GabiAndi/UNER_Autito_PCB/Presentacion/Informe.pdf

# Facultad de Ciencias de la Alimentación

Universidad Nacional de Entre Ríos

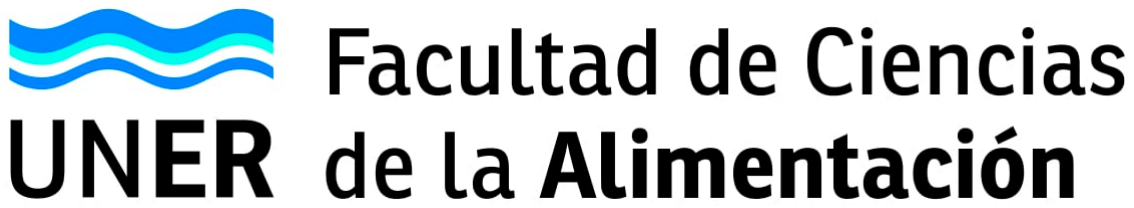
[picture p3: figure]

AUTITO MICROCONTROLADORES
Crédito de diseño y manufactura de PCB

GABRIEL ANDRÉS AGUIRRE
19 de abril de 2021

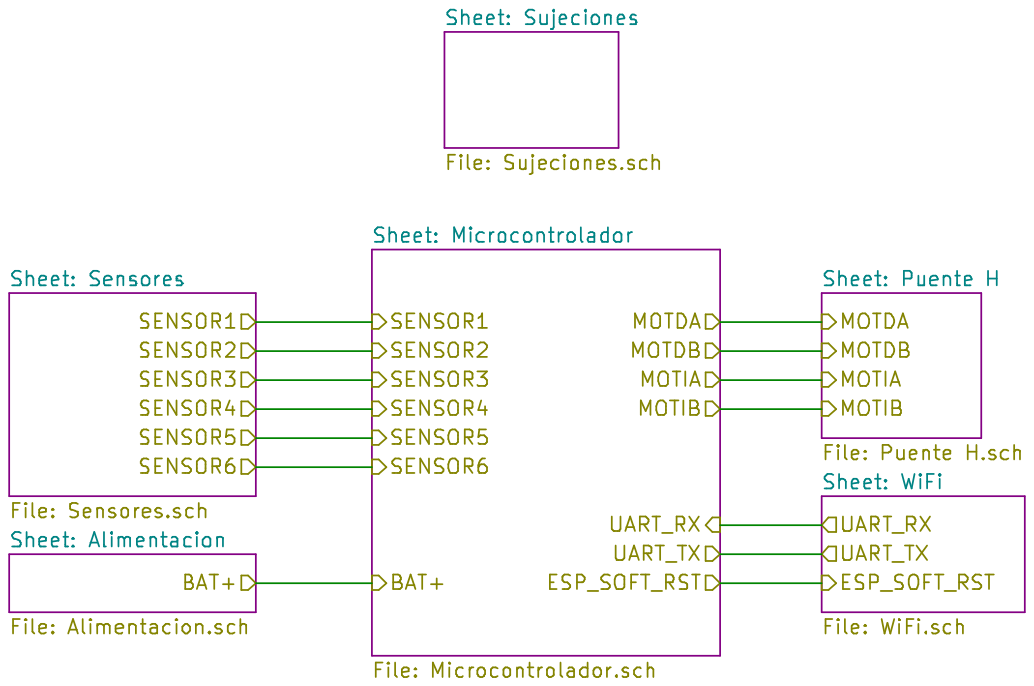
[picture p4: page 2]

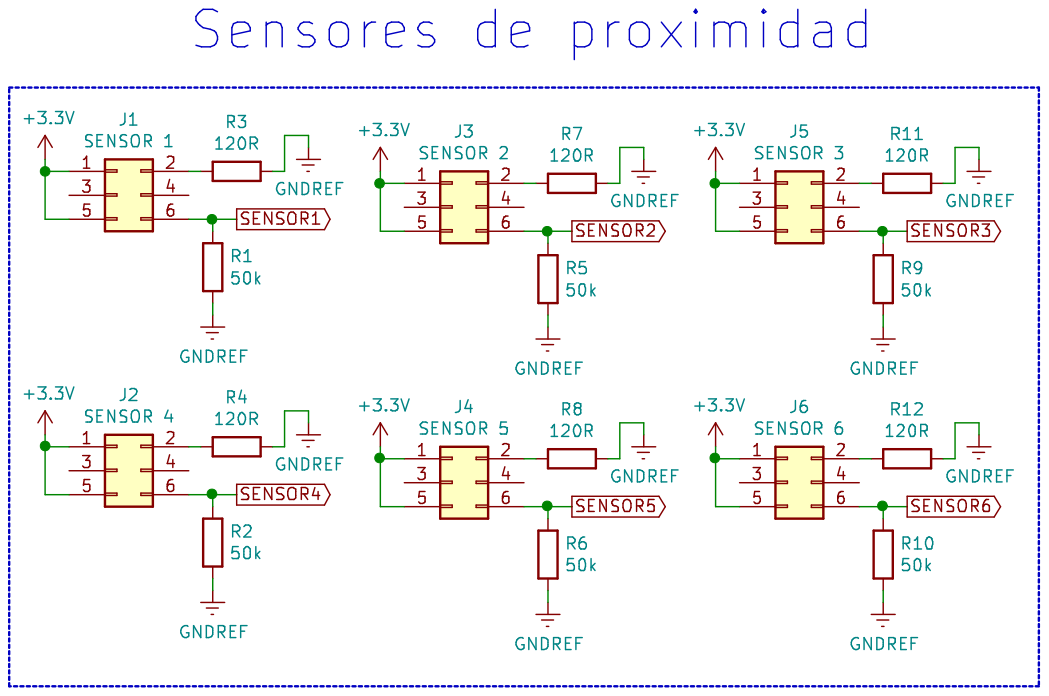
[picture p5: page 3]

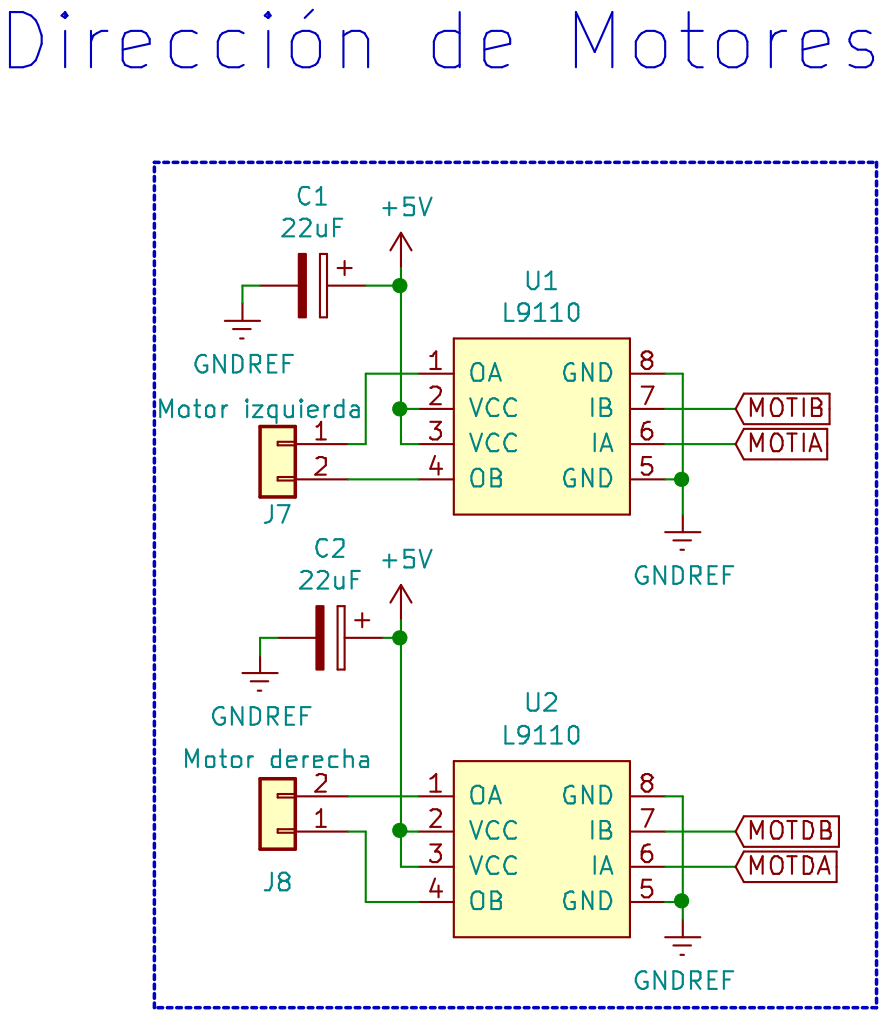
[picture p6: page 4]

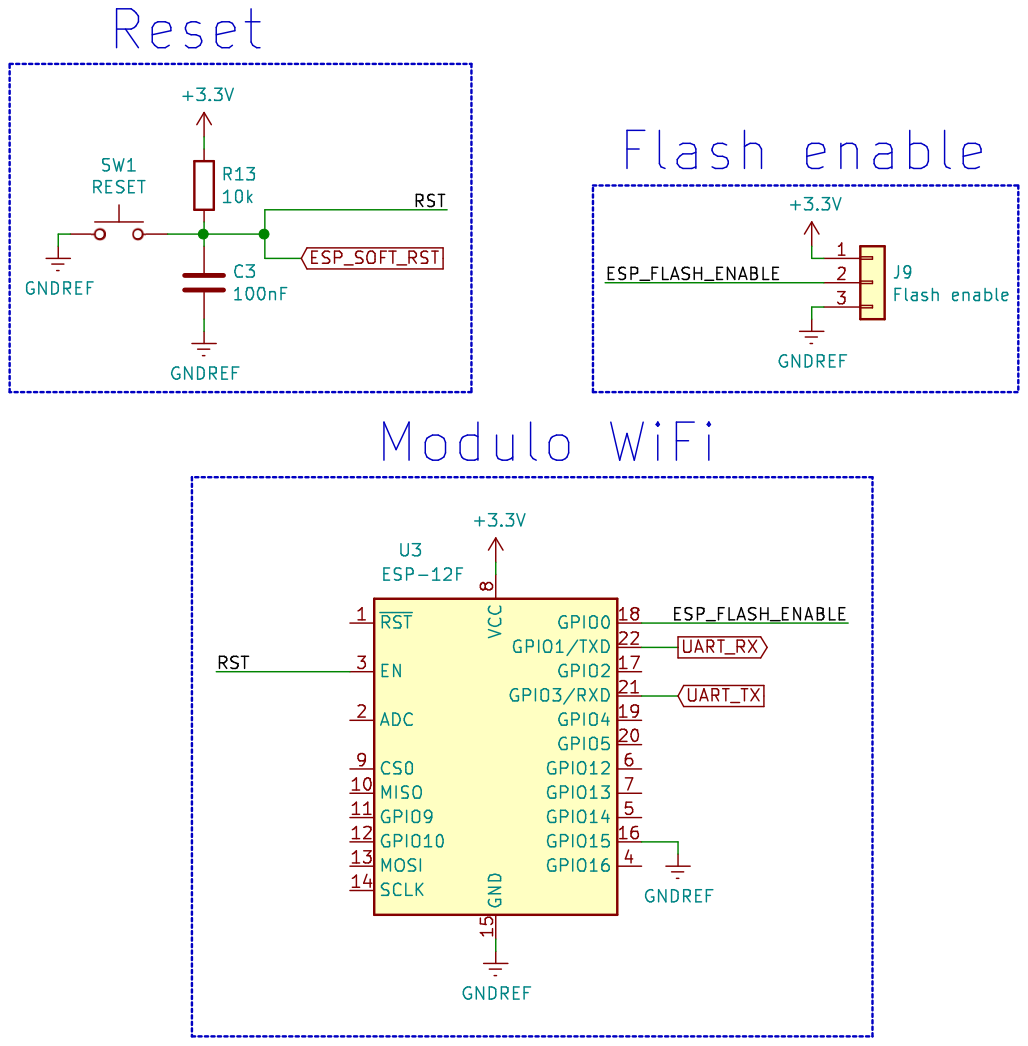
[picture p7: page 5]

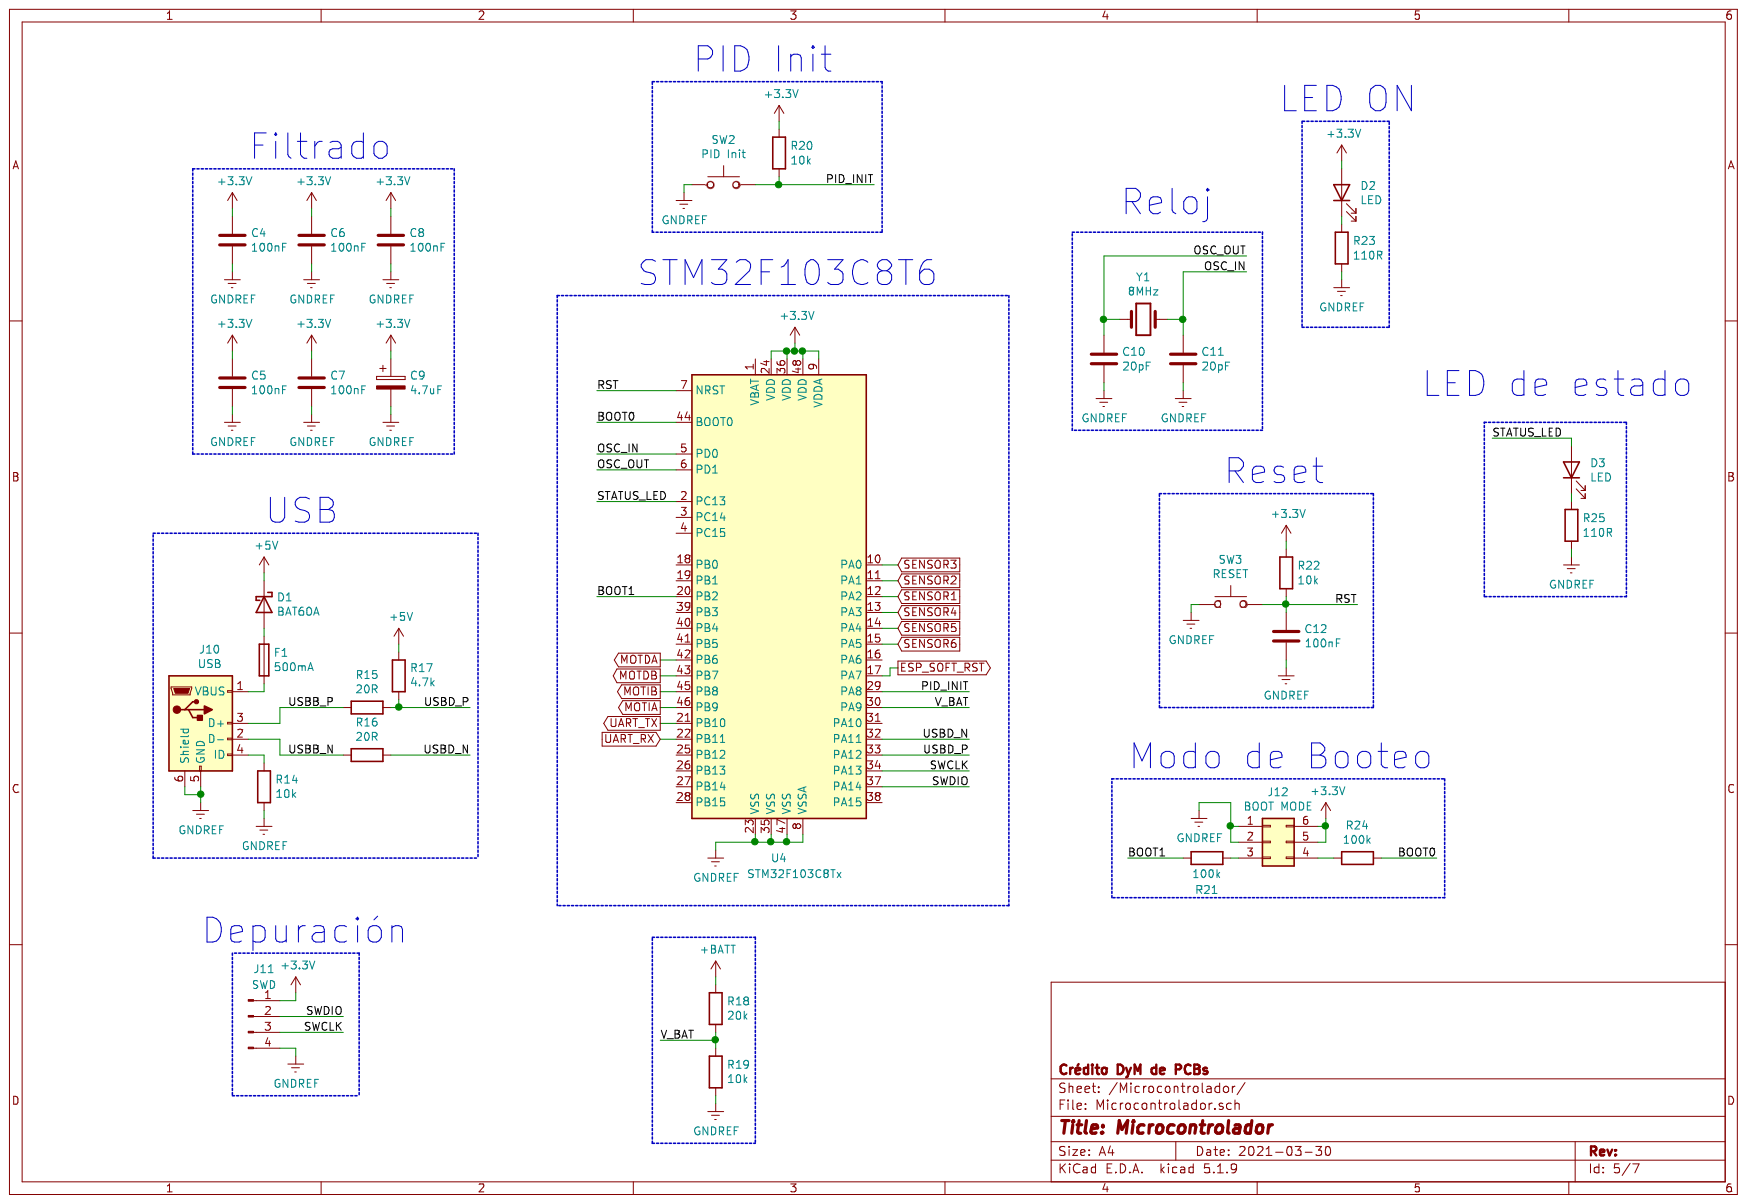
[picture p8: page 6]

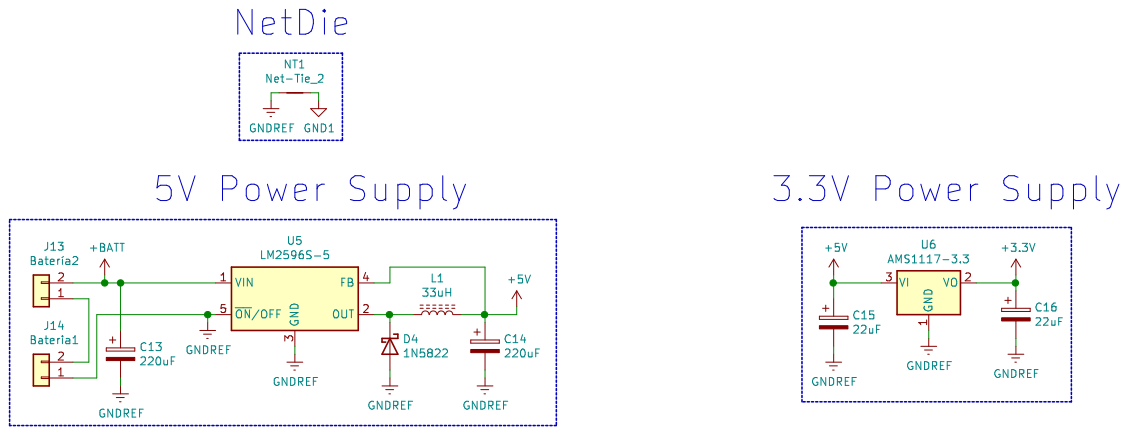
[picture p9: page 7]

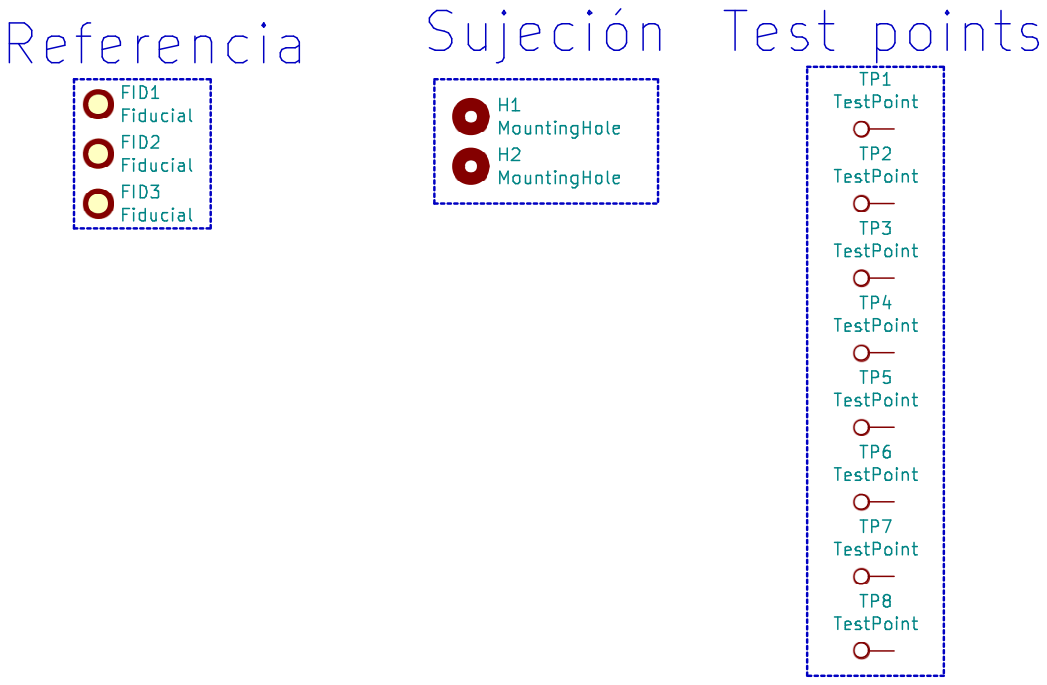
[picture p10: page 8]

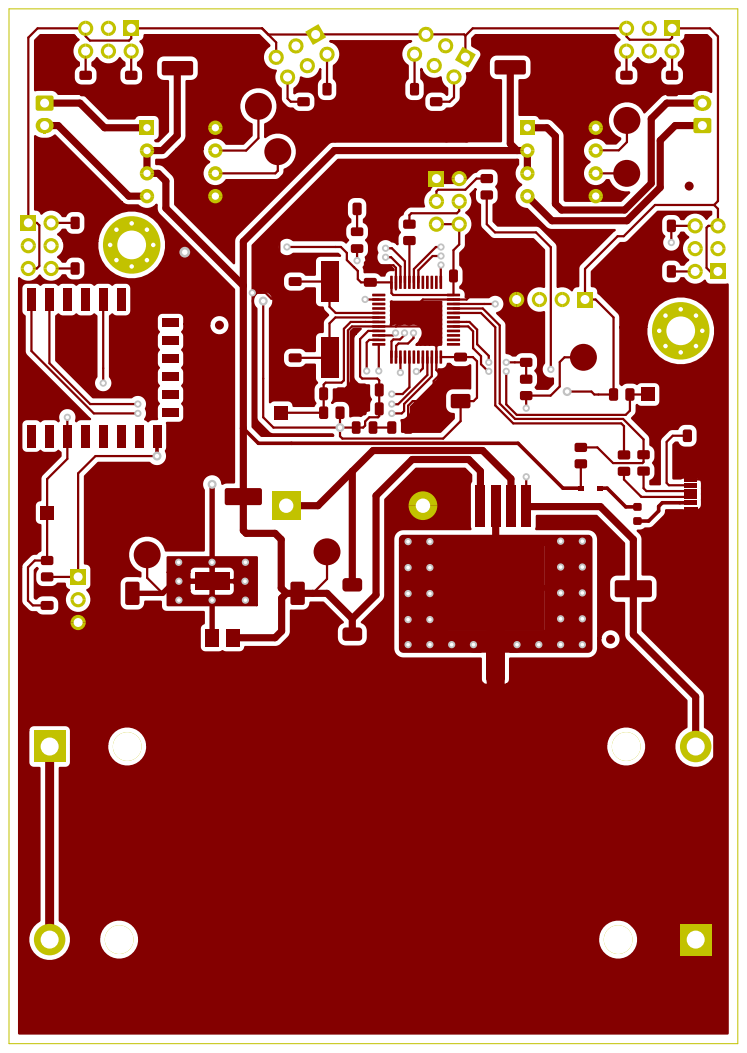
[picture p11: page 9]

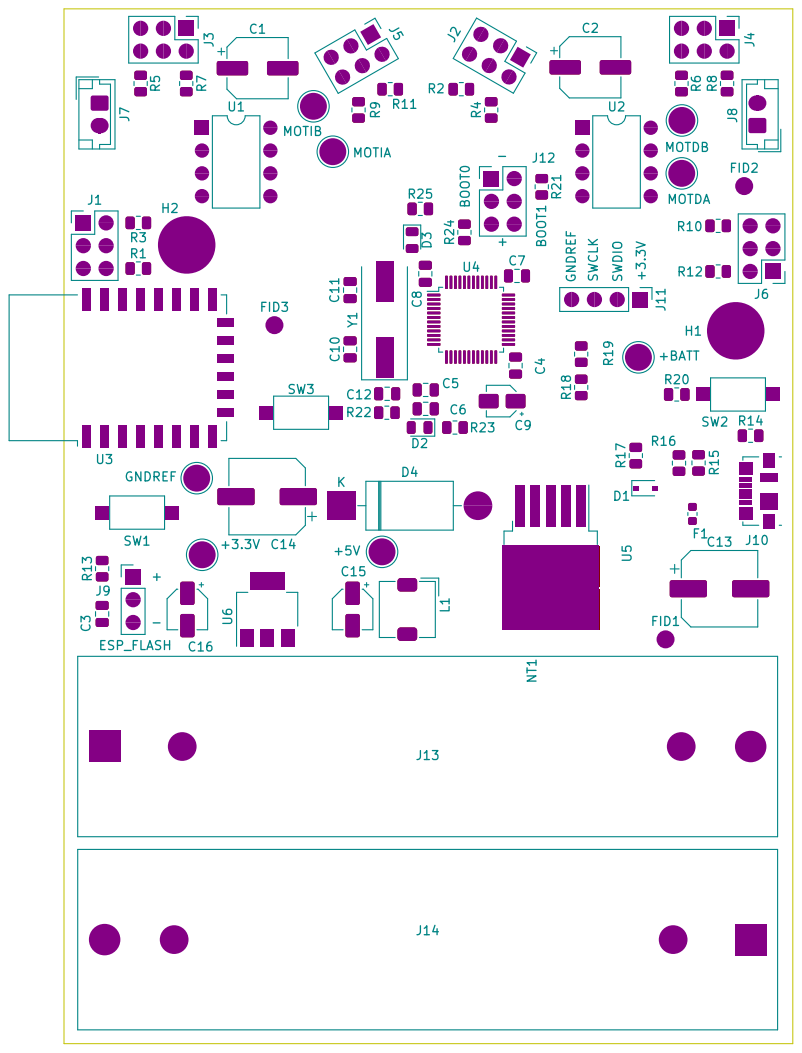
[picture p12: page 10]

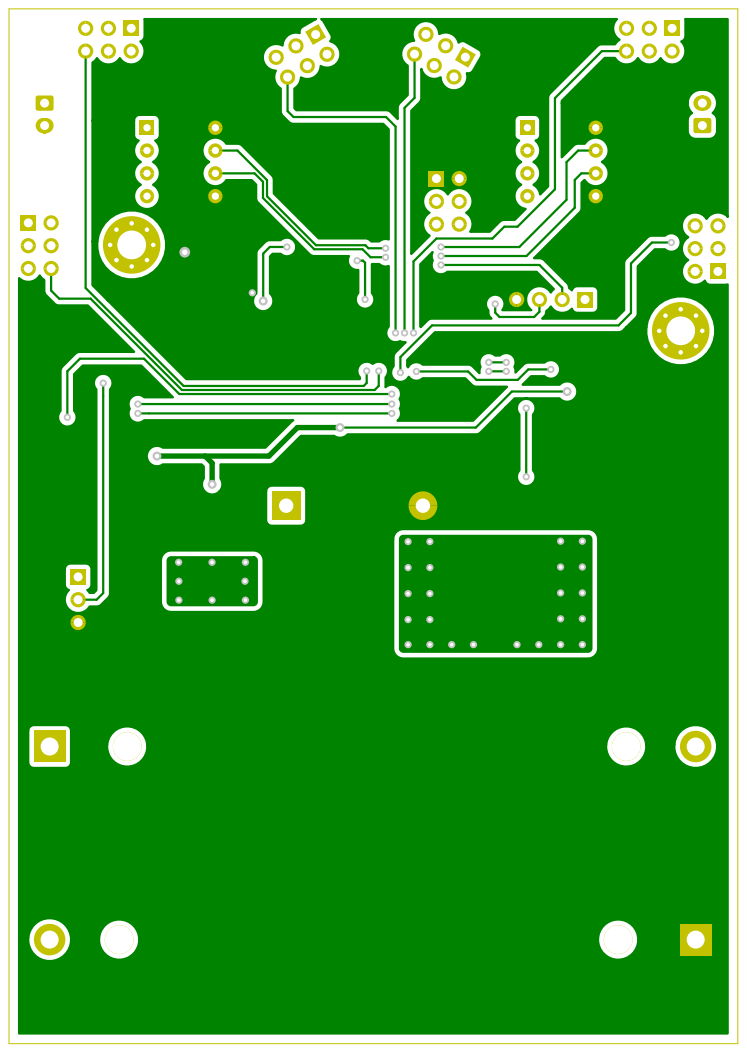
[picture p13: page 11]

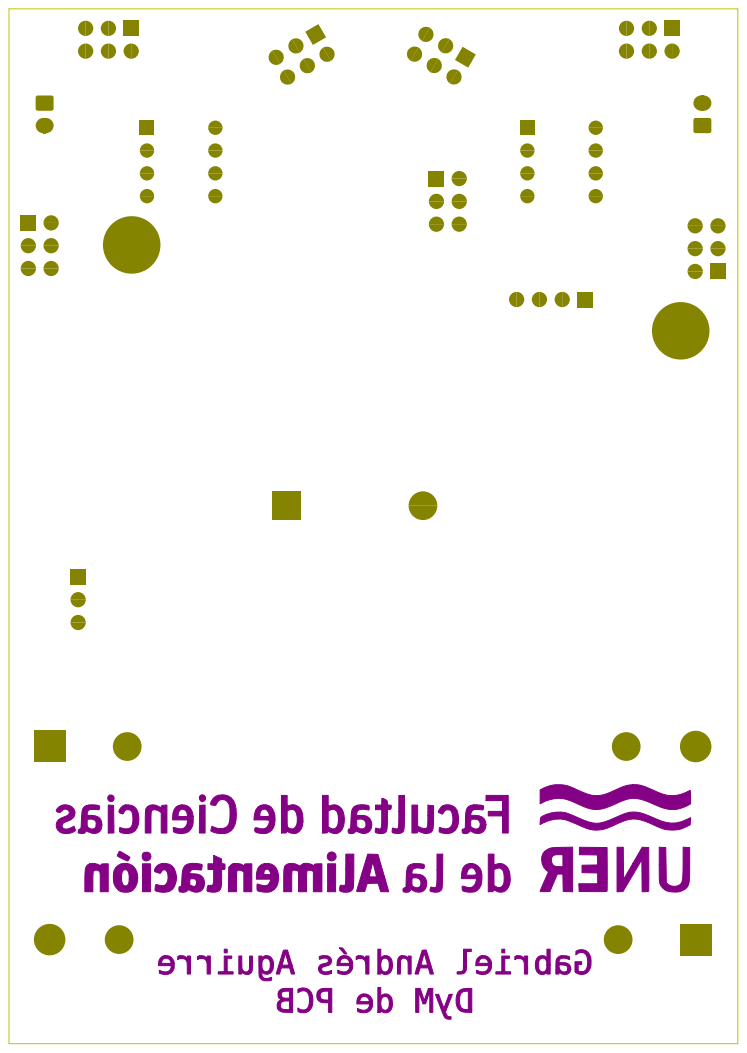
[picture p14: page 12]

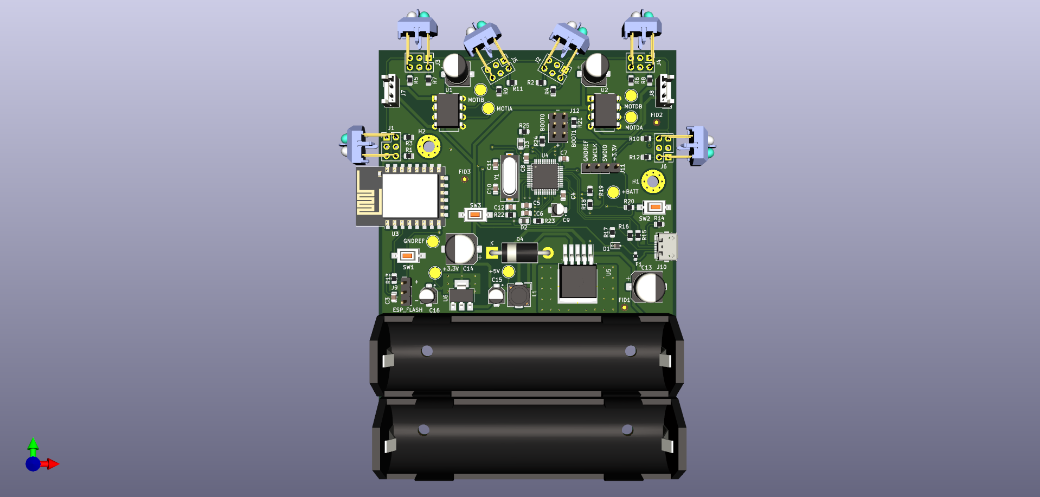
[picture p15: page 13]
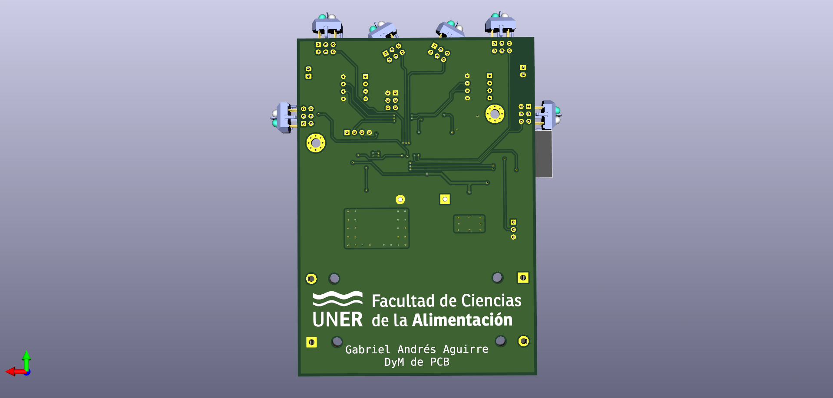
[picture p16: page 14]
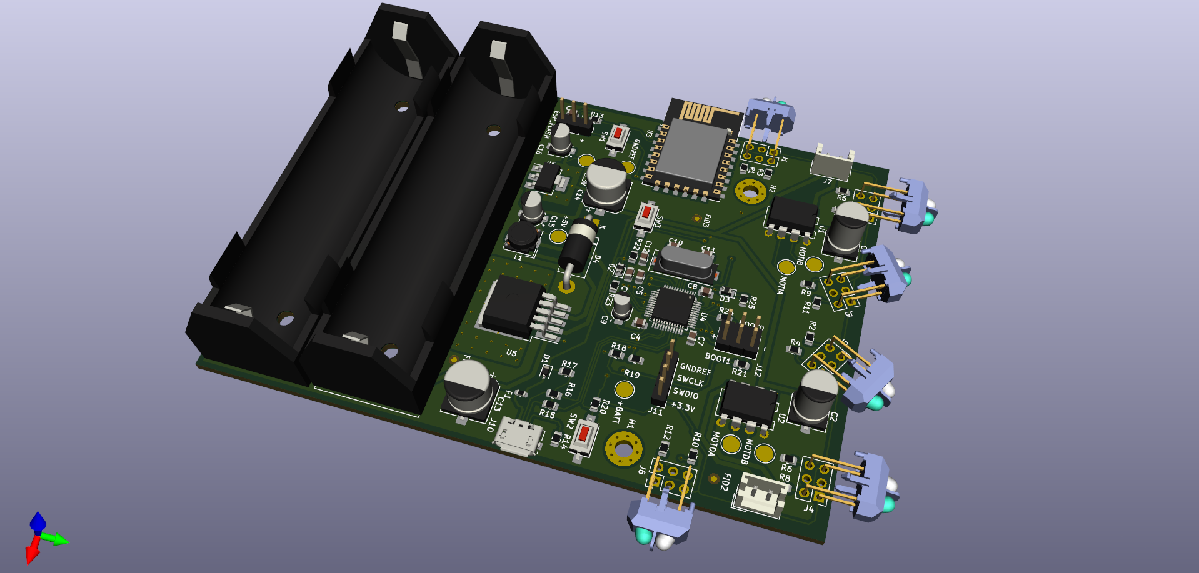
[picture p17: page 15]
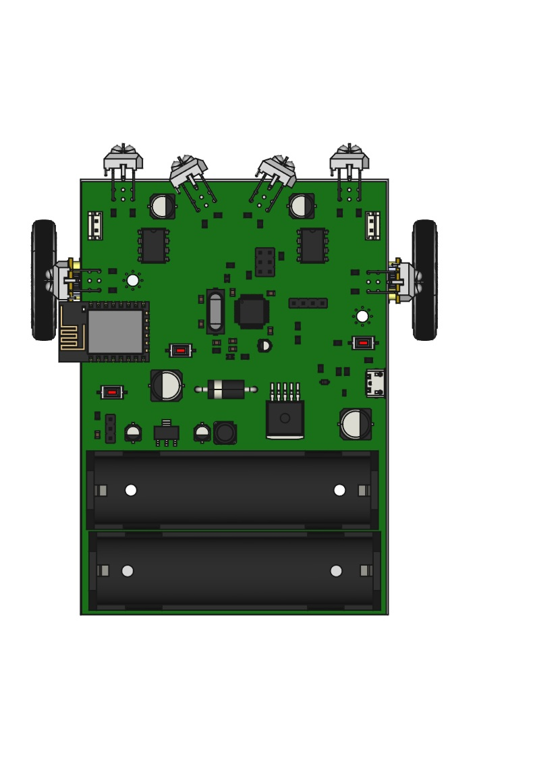
[picture p18: page 16]
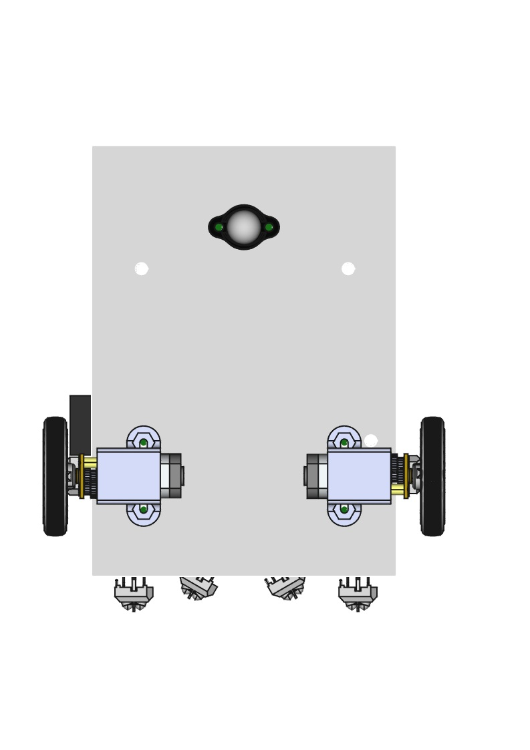
[picture p19: page 17]
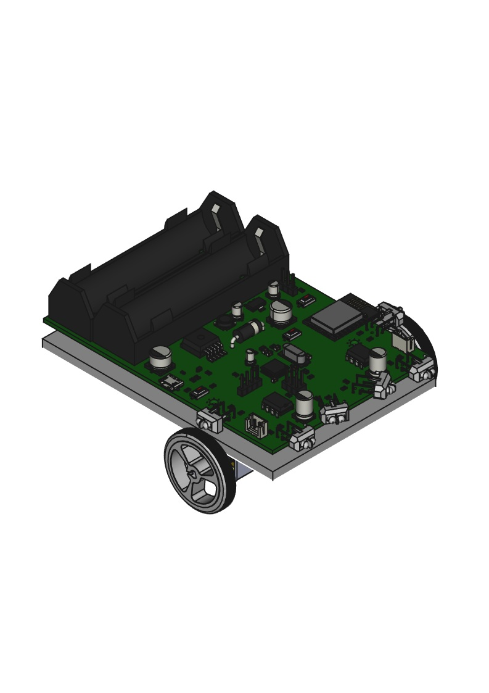
[picture p20: page 18]

# Autito Microcontroladores

## Gabriel Andrés Aguirre

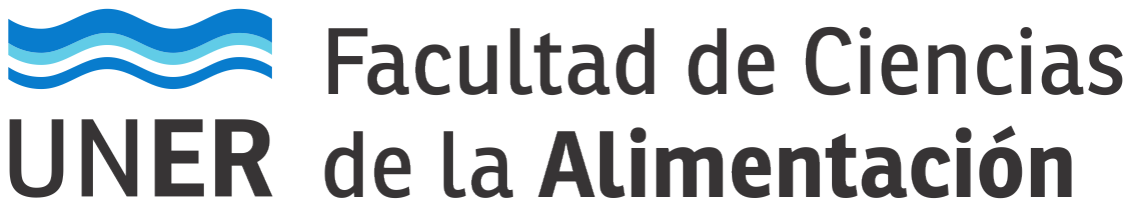
[picture p21: figure]

Componente | Referencia | Valor | Footprint | Link | Precio unidad Precio unidad Cantidad Precio | Fabricante | N.º Fabricante | Mouser N.º
Resistencias de 50k | R10, R6, R2, R9, R5, R1 | 50k | Resistor_SMD:R_0805_2012Metric | 71,32 ARS | $0,51 | 6 | $3,06 KOA Speer | RN73H2ATTD1503B25 (https://ar.mouser.com/ProductDetail/KOA-Speer/RN73H2ATTD1503B25?qs=pJKkPLTLvBhutKSsoiT5Zg%3D%3D) | 660-RN73H2ATD1503B25
Sensores infrarojos | J6, J5, J2, J4, J1, J3 | SENSOR | Mis_componentes:TCRT5000 | 121,54 ARS | $0,87 | 6 | $5,21 Vishay Semiconductors TCRT5000 (https://ar.mouser.com/ProductDetail/Vishay-Semiconductors/TCRT5000?qs=glpcD2KT6uaaYldHGIIt5g%3D%3D) | 782-TCRT5000
Resistencia de 120R | R12, R8, R4, R11, R7, R3 | 120R | Resistor_SMD:R_0805_2012Metric | 70,32 ARS | $0,50 | 6 | $3,01 Panasonic | ERA-6VEB1200V (https://ar.mouser.com/ProductDetail/Panasonic/ERA-6VEB1200V?qs=rI7uf1IzohQDwVDMjI%252BQDA%3D%3D) | 667-ERA-6VEB1200V
Puente H | U1, U2 | L9110 | Package_DIP:DIP-8_W7.62mm | 150,68 ARS | $1,08 | 2 | $2,15 Adafruit | 4489 (https://ar.mouser.com/ProductDetail/Adafruit/4489) | 485-4489
Capacitor de 22uF | C1, C2, C16, C15 | 22uF | Capacitor_SMD:CP_Elec_6.3x9.9 | 32,14 ARS | $0,23 | 4 | $0,92 Panasonic | EEE-FN1C220R (https://ar.mouser.com/ProductDetail/Panasonic/EEE-FN1C220R?qs=OlC7AqGiEDl1qZfBJQUkaQ%3D%3D) | 667-EEE-FN1C220R
Conector para motores | J7, J8 | Motor | Connector_JST:JST_EH_B2B-EH-A_1x02_P2.50mm_Vertical | 80,36 ARS | $0,57 | 2 | $1,15 JST Automotive | S06B-AIT2-1AK (https://ar.mouser.com/ProductDetail/JST-Automotive/S06B-AIT2-1AK?qs=XoGB3caz5%2FavEEj5oQr9Kw%3D%3D) | 306-S06B-AIT2-1AK
Modulo WiFi ESP8266 | U3 | ESP-12F | RF_Module:ESP-12E | 698,13 ARS | $4,99 | 1 | $4,99 Adafruit | 2491 (https://ar.mouser.com/ProductDetail/Adafruit/2491?qs=N%2F3wi2MvZWDVFv7HwruvGQ%3D%3D) | 485-2491
Capacitor de 100nF | C3, C4, C6, C5, C8, C12, C7 | 100nF | Capacitor_SMD:C_0805_2012Metric | 52,23 ARS | $0,37 | 7 | $2,61 KEMET | C0805X104M5RACTU (https://ar.mouser.com/ProductDetail/KEMET/C0805X104M5RACTU?qs=1xOl%2F8aMGNq7VJopyoJi7Q%3D%3D) | 80-C0805X104M5RACTU
Capacitor de 20pF | C10, C11 | 20pF | Capacitor_SMD:C_0805_2012Metric | 49,22 ARS | $0,35 | 2 | $0,70 AVX | 08055A200F4T2A (https://ar.mouser.com/ProductDetail/AVX/08055A200F4T2A?qs=XLNwXgtzMM869%252Bh%252B5tS56A%3D%3D) | 581-08055A200F4T2A
Boton pulsador pequeño | SW1, SW2, SW3 | Button | Button_Switch_SMD:SW_SPST_CK_RS282G05A3 | 10,05 ARS | $0,07 | 3 | $0,22 C&K (https://ar.mouser.com/ProductDetail/?qs=vLWxofP3U2xHB0Q2opWSaw%3D%3D) | PTS636 SL43 LFS | 611-PTS636SL43LFS
Resistencia de 10k | R13, R22, R14, R19, R20 | 10k | Resistor_SMD:R_0805_2012Metric | 10,05 ARS | $0,07 | 5 | $0,36 Vishay / Dale | CRCW080510K0FKEAC (https://ar.mouser.com/ProductDetail/Vishay-Dale/CRCW080510K0FKEAC?qs=E3Y5ESvWgWORadmUijPtxQ%3D%3D) | 71-CRCW080510K0FKEAC
PinHeader 01x03 | J9 | Flash enable | Connector_PinHeader_2.54mm:PinHeader_1x03_P2.54mm_Vertical | 149,67 ARS | $1,07 | 1 | $1,07 Digilent | 240-004 (https://ar.mouser.com/ProductDetail/Digilent/240-004?qs=s%2FdyVPQMB4wm5CaIPwvncg%3D%3D) | 424-6-PIN-HEADER
Cristal de 8MHz | Y1 | 8MHz | Crystal:Crystal_SMD_HC49-SD | 156,70 ARS | $1,12 | 1 | $1,12 ECS | ECS-80-20-5PVX-TR (https://ar.mouser.com/ProductDetail/ECS/ECS-80-20-5PVX-TR?qs=5lHMIjPfuwLhObXAxP2jYw%3D%3D) | 520-ECS-80-20-5PVX
Resistencia de 100k | R24, R21 | 100k | Resistor_SMD:R_0805_2012Metric | 10,05 ARS | $0,07 | 2 | $0,14 Vishay / Dale | CRCW0805100KJNEAC (https://ar.mouser.com/ProductDetail/Vishay-Dale/CRCW0805100KJNEAC?qs=E3Y5ESvWgWMMFQOyHSPe4Q%3D%3D) | 71-CRCW0805100KJNEAC
PinHeader 02x03 | J12 | BOOT MODE | Connector_PinHeader_2.54mm:PinHeader_2x03_P2.54mm_Vertical | 210,95 ARS | $1,51 | 1 | $1,51 Digilent | 240-062 (https://ar.mouser.com/ProductDetail/Digilent/240-062?qs=s%2FdyVPQMB4zHQ1ZSIfSl4A%3D%3D) | 424-2X6-PIN-HEADER
PinHeader 01x04 | J11 | SWD | Connector_PinHeader_2.54mm:PinHeader_1x04_P2.54mm_Vertical | 149,67 ARS | $1,07 | 1 | $1,07 Digilent | 240-004 (https://ar.mouser.com/ProductDetail/Digilent/240-004?qs=s%2FdyVPQMB4wm5CaIPwvncg%3D%3D) | 424-6-PIN-HEADER
Resistencia de 20R | R15, R16 | 20R | Resistor_SMD:R_0805_2012Metric | 25,11 ARS | $0,18 | 2 | $0,36 Vishay / Dale | RCS080520R0FKEA (https://ar.mouser.com/ProductDetail/Vishay-Dale/RCS080520R0FKEA?qs=AAB0DUhlpksnVW12to%2FpqA%3D%3D) | 71-RCS080520R0FKEA
Conector micro USB hermbra | J10 | USB | Connector_USB:USB_Micro-B_Molex_47346-0001 | 45,20 ARS | $0,32 | 1 | $0,32 CUI Devices | UJ2-MIBH-G-SMT-TR | 490-UJ2-MIBH-G-SMTTR (https://ar.mouser.com/ProductDetail/CUI-Devices/UJ2-MIBH-G-SMT-TR)
Resistencia de 4,7k | R17 | 4.7k | Resistor_SMD:R_0805_2012Metric | 10,05 ARS | $0,07 | 1 | $0,07 Vishay / Dale | CRCW08054K70JNEA (https://ar.mouser.com/ProductDetail/Vishay-Dale/CRCW08054K70JNEA?qs=kkyyugUlSrPc3tCn%2F8R5yw%3D%3D) | 71-CRCW0805J-4.7K-E3
Resistencia de 20k | R18 | 20k | Resistor_SMD:R_0805_2012Metric | 10,05 ARS | $0,07 | 1 | $0,07 Vishay / Dale | CRCW080520K0FKEAC (https://ar.mouser.com/ProductDetail/Vishay-Dale/CRCW080520K0FKEAC?qs=E3Y5ESvWgWNXVYIsIc630g%3D%3D) | 71-CRCW080520K0FKEAC
Capacitor de 4,7uF | C9 | 4.7uF | Capacitor_SMD:CP_Elec_3x5.4 | 30,14 ARS | $0,22 | 1 | $0,22 Wurth Elektronik | 865090468011 (https://ar.mouser.com/ProductDetail/Wurth-Elektronik/865090468011?qs=l7cgNqFNU1hyUk3g6abBGQ%3D%3D) | 710-865090468011
LED verde | D3 | LED | Diode_SMD:D_0805_2012Metric | 39,18 ARS | $0,28 | 1 | $0,28 Dialight | 598-8C80-102F (https://ar.mouser.com/ProductDetail/Dialight/598-8C80-102F?qs=hWgE7mdIu5QufY11KQ%2FRug%3D%3D) | 645-598-8C80-102F
LED naranja | D2 | LED | Diode_SMD:D_0805_2012Metric | 34,15 ARS | $0,24 | 1 | $0,24 Dialight | 598-8C30-102F (https://ar.mouser.com/ProductDetail/Dialight/598-8C30-102F?qs=hWgE7mdIu5QsN4%252BAG7KlCg%3D%3D) | 645-598-8C30-102F
Resistencia de 10R | R25, R23 | 110R | Resistor_SMD:R_0805_2012Metric | 16,07 ARS | $0,11 | 2 | $0,23 Vishay / Dale | CRCW0805110RFKEAC | 71-CRCW0805110RFKEAC (https://ar.mouser.com/ProductDetail/Vishay-Dale/CRCW0805110RFKEAC?qs=E3Y5ESvWgWMNpf%252BYjZabPQ%3D%3D)
Fusible rearmable de 500mA | F1 | 500mA | Fuse:Fuse_0603_1608Metric | 92,41 ARS | $0,66 | 1 | $0,66 Littelfuse | 1812L050/60MR | 576-1812L050/60MR (https://ar.mouser.com/ProductDetail/Littelfuse/1812L050-60MR)
Diodo de baja caida | D1 | BAT60A | Diode_SMD:D_SOD-323 | 45,20 ARS | $0,32 | 1 | $0,32 Infineon Technologies | BAT 60A E6327 (https://ar.mouser.com/ProductDetail/Infineon-Technologies/BAT-60A-E6327?qs=QdTgSBuqQUO0UTmzztPfRw%3D%3D) | 726-BAT60AE6327
STM microcontrolador | U4 | STM32F103C8Tx | Package_QFP:LQFP-48_7x7mm_P0.5mm | 571,56 ARS | $4,08 | 1 | $4,08 STMicroelectronics | STM32F103CBT6 (https://ar.mouser.com/ProductDetail/STMicroelectronics/STM32F103CBT6?qs=WxFF5lh7QM3goh6GV5Ogig%3D%3D) | 511-STM32F103CBT6
Conversor DC-DC a 5V | U5 | LM2596S-5 | Package_TO_SOT_SMD:TO-263-5_TabPin3 | 609,73 ARS | $4,36 | 1 | $4,36 Texas Instruments | LM2596S-5.0/NOPB | 926-LM2596S-5.0/NOPB (https://ar.mouser.com/ProductDetail/Texas-Instruments/LM2596S-50-NOPB?qs=X1J7HmVL2ZHVjCOmW%252BYINA%3D%3D)
Capacitor de 220uF | C14, C13 | 220uF | Capacitor_SMD:CP_Elec_8x6.9 | 212,95 ARS | $1,52 | 2 | $3,04 Nichicon | PCH1C221MCL1GS (https://ar.mouser.com/ProductDetail/Nichicon/PCH1C221MCL1GS?qs=vmHwEFxEFR%2FMyJp93I%2F7QA%3D%3D) | 647-PCH1C221MCL1GS
Inductor de 33uH | L1 | 33uH | Inductor_SMD:L_TDK_SLF6045 | 177,80 ARS | $1,27 | 1 | $1,27 Taiyo Yuden | NS10145T330MNV8 (https://ar.mouser.com/ProductDetail/Taiyo-Yuden/NS10145T330MNV8?qs=hWgE7mdIu5SA9O15JDEKtw%3D%3D) | 963-NS10145T330MNV8
Conversor lineal 5V a 3,3V | U6 | AMS1117-3.3 | Package_TO_SOT_SMD:SOT-223-3_TabPin2 | 66,00 ARS | $0,47 | 1 | $0,47 Texas Instruments | LM1117MPX-3.3/NOPB | 926-LM1117MPX3.3NOPB (https://ar.mouser.com/ProductDetail/Texas-Instruments/LM1117MPX-33-NOPB)
Diodo Schotky | D4 | 1N5822 | Diode_THT:D_DO-201AD_P15.24mm_Horizontal | 115,52 ARS | $0,83 | 1 | $0,83 STMicroelectronics | 1N5822 (https://ar.mouser.com/ProductDetail/STMicroelectronics/1N5822?qs=JV7lzlMm3yJ50hlrGV6%252BnQ%3D%3D) | 511-1N5822
Conector de bateria | J13, J14 | Batería2 | Battery:BatteryHolder_MPD_BH-18650-PC2 | 259,16 ARS | $1,85 | 2 | $3,70 Keystone Electronics | 1043 (https://ar.mouser.com/ProductDetail/Keystone-Electronics/1043?qs=%2F7TOpeL5Mz6j%2FnxeOA1rsg%3D%3D) | 534-1043
Bateria 18650 | BAT1, BAT2 | Batería2 | 18650 | 427,00 ARS | $3,05 | 2 | $6,10 18650 | 18650 | 18650 (https://articulo.mercadolibre.com.ar/MLA-816550268-pila-bateria-recargable-18650-6800mah-37v-para-linterna-_JM)
Motores 6V | MOT1, MOT2 | Motor izquierda | 6V | 750,36 ARS | $5,36 | 2 | $10,72 TinyCircuits | ASR00016 (https://ar.mouser.com/ProductDetail/TinyCircuits/ASR00016?qs=55YtniHzbhCxReJw9pjq7w%3D%3D) | 406-ASR00016
Llantas para motor | YANT1, YANT2 | Llantas | Para motor | 189,00 ARS | $1,35 | 2 | $2,70 Impreso (https://teslabem.com/tienda/par-de-llantas-negras-pololu-32x7mm-para-micromotor/) | 2343
Rueda loca | RL | Rueda loca | 3/8 inch | 172,00 ARS | $1,23 | 1 | $1,23 POLOLU (https://robots-educativos.ddns.net/es/kits/2389-pololu-ball-caster-with-3-8-inch-metal-ball.html) | P000951
Soporte motor | MT | Soporte | Pololu | 427,00 ARS | $3,05 | 2 | $6,10 POLOLU | P000989 (https://robots-educativos.ddns.net/es/kits/2395-pololu-micro-metal-gearmotor-bracket-pair-black.html)
Precio total | $76,65
| $10.731,68

https://ar.mouser.com/ProductDetail/KOA-Speer/RN73H2ATTD1503B25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
https://robots-educativos.ddns.net/es/kits/2389-pololu-ball-caster-with-3-8-inch-metal-ball.html
https://robots-educativos.ddns.net/es/kits/2395-pololu-micro-metal-gearmotor-bracket-pair-black.html

## Autito Microcontroladores

Gabriel Andrés Aguirre
Componente | Referencia | Valor | Footprint
Resistencias de 50k | R10, R6, R2, R9, R5, R1 | 50k | Resistor_SMD:R_0805_2012Metric
Sensores infrarojos | J6, J5, J2, J4, J1, J3 | SENSOR | Mis_componentes:TCRT5000
Resistencia de 120R | R12, R8, R4, R11, R7, R3 | 120R | Resistor_SMD:R_0805_2012Metric
Puente H | U1, U2 | L9110 | Package_DIP:DIP-8_W7.62mm
Capacitor de 22uF | C1, C2, C16, C15 | 22uF | Capacitor_SMD:CP_Elec_6.3x9.9
Conector para motores | J7, J8 | Motor | Connector_JST:JST_EH_B2B-EH-A_1x02_P2.50mm_Vertical
Modulo WiFi ESP8266 | U3 | ESP-12F | RF_Module:ESP-12E
Capacitor de 100nF | C3, C4, C6, C5, C8, C12, C7 | 100nF | Capacitor_SMD:C_0805_2012Metric
Capacitor de 20pF | C10, C11 | 20pF | Capacitor_SMD:C_0805_2012Metric
Boton pulsador pequeño | SW1, SW2, SW3 | Button | Button_Switch_SMD:SW_SPST_CK_RS282G05A3
Resistencia de 10k | R13, R22, R14, R19, R20 | 10k | Resistor_SMD:R_0805_2012Metric
PinHeader 01x03 | J9 | Flash enable | Connector_PinHeader_2.54mm:PinHeader_1x03_P2.54mm_Vertical
Cristal de 8MHz | Y1 | 8MHz | Crystal:Crystal_SMD_HC49-SD
Resistencia de 100k | R24, R21 | 100k | Resistor_SMD:R_0805_2012Metric
PinHeader 02x03 | J12 | BOOT MODE | Connector_PinHeader_2.54mm:PinHeader_2x03_P2.54mm_Vertical
PinHeader 01x04 | J11 | SWD | Connector_PinHeader_2.54mm:PinHeader_1x04_P2.54mm_Vertical
Resistencia de 20R | R15, R16 | 20R | Resistor_SMD:R_0805_2012Metric
Conector micro USB hermbra | J10 | USB | Connector_USB:USB_Micro-B_Molex_47346-0001
Resistencia de 4,7k | R17 | 4.7k | Resistor_SMD:R_0805_2012Metric
Resistencia de 20k | R18 | 20k | Resistor_SMD:R_0805_2012Metric
Capacitor de 4,7uF | C9 | 4.7uF | Capacitor_SMD:CP_Elec_3x5.4
LED verde | D3 | LED | Diode_SMD:D_0805_2012Metric
LED naranja | D2 | LED | Diode_SMD:D_0805_2012Metric
Resistencia de 10R | R25, R23 | 110R | Resistor_SMD:R_0805_2012Metric
Fusible rearmable de 500mA | F1 | 500mA | Fuse:Fuse_0603_1608Metric
Diodo de baja caida | D1 | BAT60A | Diode_SMD:D_SOD-323
STM microcontrolador | U4 | STM32F103C8Tx | Package_QFP:LQFP-48_7x7mm_P0.5mm
Conversor DC-DC a 5V | U5 | LM2596S-5 | Package_TO_SOT_SMD:TO-263-5_TabPin3
Capacitor de 220uF | C14, C13 | 220uF | Capacitor_SMD:CP_Elec_8x6.9
Inductor de 33uH | L1 | 33uH | Inductor_SMD:L_TDK_SLF6045
Conversor lineal 5V a 3,3V | U6 | AMS1117-3.3 | Package_TO_SOT_SMD:SOT-223-3_TabPin2
Diodo Schotky | D4 | 1N5822 | Diode_THT:D_DO-201AD_P15.24mm_Horizontal
Conector de bateria | J13, J14 | Batería2 | Battery:BatteryHolder_MPD_BH-18650-PC2

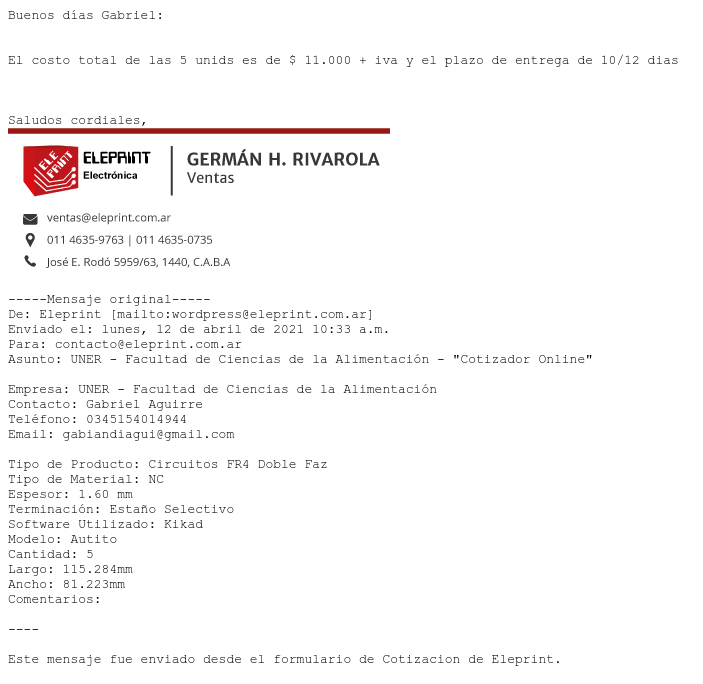
[picture p22: page 21]
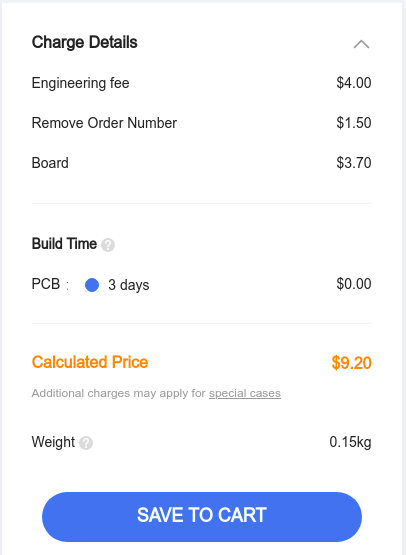
[picture p23: page 22]
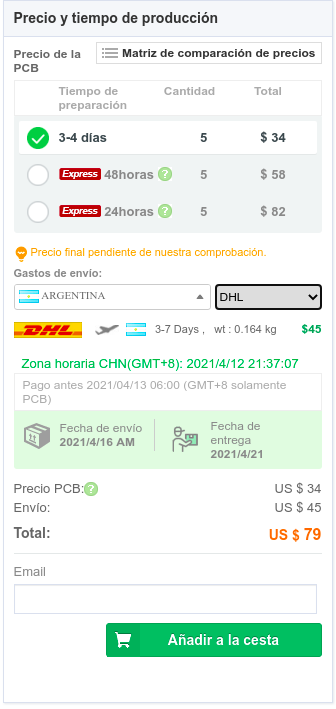
[picture p24: page 23]
