GabiAndi/UNER_Autito_PCB/PDF/Presentacion.pdf

# Facultad de Ciencias de la Alimentación

### Universidad Nacional de Entre Ríos


AUTITO MICROCONTROLADORES
Crédito de diseño y manufactura de PCB

GABRIEL ANDRÉS AGUIRRE
19 de abril de 2021
