GabiAndi/UNER_Autito_PCB/Cotizaciones/Hoja de componentes.xlsx

 |  |  | Autito Microcontroladores
 |  |  | Gabriel Andrés Aguirre
Componente | Referencia | Valor | Footprint | Link | Precio unidad | Precio unidad | Cantidad | Precio | Fabricante | N.º Fabricante | Mouser N.º
Resistencias de 50k | R10, R6, R2, R9, R5, R1 | 50k | Resistor_SMD:R_0805_2012Metric | https://ar.mouser.com/ProductDetail/KOA-Speer/RN73H2ATTD1503B25?qs=pJKkPLTLvBhutKSsoiT5Zg%3D%3D | 71.32 ARS | $0.51 | 6 | $3.06 | KOA Speer | RN73H2ATTD1503B25 | 660-RN73H2ATD1503B25
Sensores infrarojos | J6, J5, J2, J4, J1, J3 | SENSOR | Mis_componentes:TCRT5000 | https://ar.mouser.com/ProductDetail/Vishay-Semiconductors/TCRT5000?qs=glpcD2KT6uaaYldHGIIt5g%3D%3D | 121.54 ARS | $0.87 | 6 | $5.21 | Vishay Semiconductors | TCRT5000 | 782-TCRT5000
Resistencia de 120R | R12, R8, R4, R11, R7, R3 | 120R | Resistor_SMD:R_0805_2012Metric | https://ar.mouser.com/ProductDetail/Panasonic/ERA-6VEB1200V?qs=rI7uf1IzohQDwVDMjI%252BQDA%3D%3D | 70.32 ARS | $0.50 | 6 | $3.01 | Panasonic | ERA-6VEB1200V | 667-ERA-6VEB1200V
Puente H | U1, U2 | L9110 | Package_DIP:DIP-8_W7.62mm | https://ar.mouser.com/ProductDetail/Adafruit/4489 | 150.68 ARS | $1.08 | 2 | $2.15 | Adafruit | 4489 | 485-4489
Capacitor de 22uF | C1, C2, C16, C15 | 22uF | Capacitor_SMD:CP_Elec_6.3x9.9 | https://ar.mouser.com/ProductDetail/Panasonic/EEE-FN1C220R?qs=OlC7AqGiEDl1qZfBJQUkaQ%3D%3D | 32.14 ARS | $0.23 | 4 | $0.92 | Panasonic | EEE-FN1C220R | 667-EEE-FN1C220R
Conector para motores | J7, J8 | Motor | Connector_JST:JST_EH_B2B-EH-A_1x02_P2.50mm_Vertical | https://ar.mouser.com/ProductDetail/JST-Automotive/S06B-AIT2-1AK?qs=XoGB3caz5%2FavEEj5oQr9Kw%3D%3D | 80.36 ARS | $0.57 | 2 | $1.15 | JST Automotive | S06B-AIT2-1AK | 306-S06B-AIT2-1AK
Modulo WiFi ESP8266 | U3 | ESP-12F | RF_Module:ESP-12E | https://ar.mouser.com/ProductDetail/Adafruit/2491?qs=N%2F3wi2MvZWDVFv7HwruvGQ%3D%3D | 698.13 ARS | $4.99 | 1 | $4.99 | Adafruit | 2491 | 485-2491
Capacitor de 100nF | C3, C4, C6, C5, C8, C12, C7 | 100nF | Capacitor_SMD:C_0805_2012Metric | https://ar.mouser.com/ProductDetail/KEMET/C0805X104M5RACTU?qs=1xOl%2F8aMGNq7VJopyoJi7Q%3D%3D | 52.23 ARS | $0.37 | 7 | $2.61 | KEMET | C0805X104M5RACTU | 80-C0805X104M5RACTU
Capacitor de 20pF | C10, C11 | 20pF | Capacitor_SMD:C_0805_2012Metric | https://ar.mouser.com/ProductDetail/AVX/08055A200F4T2A?qs=XLNwXgtzMM869%252Bh%252B5tS56A%3D%3D | 49.22 ARS | $0.35 | 2 | $0.70 | AVX | 08055A200F4T2A | 581-08055A200F4T2A
Boton pulsador pequeño | SW1, SW2, SW3 | Button | Button_Switch_SMD:SW_SPST_CK_RS282G05A3 | https://ar.mouser.com/ProductDetail/?qs=vLWxofP3U2xHB0Q2opWSaw%3D%3D | 10.05 ARS | $0.07 | 3 | $0.22 | C&K | PTS636 SL43 LFS | 611-PTS636SL43LFS
Resistencia de 10k | R13, R22, R14, R19, R20 | 10k | Resistor_SMD:R_0805_2012Metric | https://ar.mouser.com/ProductDetail/Vishay-Dale/CRCW080510K0FKEAC?qs=E3Y5ESvWgWORadmUijPtxQ%3D%3D | 10.05 ARS | $0.07 | 5 | $0.36 | Vishay / Dale | CRCW080510K0FKEAC | 71-CRCW080510K0FKEAC
PinHeader 01x03 | J9 | Flash enable | Connector_PinHeader_2.54mm:PinHeader_1x03_P2.54mm_Vertical | https://ar.mouser.com/ProductDetail/Digilent/240-004?qs=s%2FdyVPQMB4wm5CaIPwvncg%3D%3D | 149.67 ARS | $1.07 | 1 | $1.07 | Digilent | 240-004 | 424-6-PIN-HEADER
Cristal de 8MHz | Y1 | 8MHz | Crystal:Crystal_SMD_HC49-SD | https://ar.mouser.com/ProductDetail/ECS/ECS-80-20-5PVX-TR?qs=5lHMIjPfuwLhObXAxP2jYw%3D%3D | 156.70 ARS | $1.12 | 1 | $1.12 | ECS | ECS-80-20-5PVX-TR | 520-ECS-80-20-5PVX
Resistencia de 100k | R24, R21 | 100k | Resistor_SMD:R_0805_2012Metric | https://ar.mouser.com/ProductDetail/Vishay-Dale/CRCW0805100KJNEAC?qs=E3Y5ESvWgWMMFQOyHSPe4Q%3D%3D | 10.05 ARS | $0.07 | 2 | $0.14 | Vishay / Dale | CRCW0805100KJNEAC | 71-CRCW0805100KJNEAC
PinHeader 02x03 | J12 | BOOT MODE | Connector_PinHeader_2.54mm:PinHeader_2x03_P2.54mm_Vertical | https://ar.mouser.com/ProductDetail/Digilent/240-062?qs=s%2FdyVPQMB4zHQ1ZSIfSl4A%3D%3D | 210.95 ARS | $1.51 | 1 | $1.51 | Digilent | 240-062 | 424-2X6-PIN-HEADER
PinHeader 01x04 | J11 | SWD | Connector_PinHeader_2.54mm:PinHeader_1x04_P2.54mm_Vertical | https://ar.mouser.com/ProductDetail/Digilent/240-004?qs=s%2FdyVPQMB4wm5CaIPwvncg%3D%3D | 149.67 ARS | $1.07 | 1 | $1.07 | Digilent | 240-004 | 424-6-PIN-HEADER
Resistencia de 20R | R15, R16 | 20R | Resistor_SMD:R_0805_2012Metric | https://ar.mouser.com/ProductDetail/Vishay-Dale/RCS080520R0FKEA?qs=AAB0DUhlpksnVW12to%2FpqA%3D%3D | 25.11 ARS | $0.18 | 2 | $0.36 | Vishay / Dale | RCS080520R0FKEA | 71-RCS080520R0FKEA
Conector micro USB hermbra | J10 | USB | Connector_USB:USB_Micro-B_Molex_47346-0001 | https://ar.mouser.com/ProductDetail/CUI-Devices/UJ2-MIBH-G-SMT-TR | 45.20 ARS | $0.32 | 1 | $0.32 | CUI Devices | UJ2-MIBH-G-SMT-TR | 490-UJ2-MIBH-G-SMTTR
Resistencia de 4,7k | R17 | 4.7k | Resistor_SMD:R_0805_2012Metric | https://ar.mouser.com/ProductDetail/Vishay-Dale/CRCW08054K70JNEA?qs=kkyyugUlSrPc3tCn%2F8R5yw%3D%3D | 10.05 ARS | $0.07 | 1 | $0.07 | Vishay / Dale | CRCW08054K70JNEA | 71-CRCW0805J-4.7K-E3
Resistencia de 20k | R18 | 20k | Resistor_SMD:R_0805_2012Metric | https://ar.mouser.com/ProductDetail/Vishay-Dale/CRCW080520K0FKEAC?qs=E3Y5ESvWgWNXVYIsIc630g%3D%3D | 10.05 ARS | $0.07 | 1 | $0.07 | Vishay / Dale | CRCW080520K0FKEAC | 71-CRCW080520K0FKEAC
Capacitor de 4,7uF | C9 | 4.7uF | Capacitor_SMD:CP_Elec_3x5.4 | https://ar.mouser.com/ProductDetail/Wurth-Elektronik/865090468011?qs=l7cgNqFNU1hyUk3g6abBGQ%3D%3D | 30.14 ARS | $0.22 | 1 | $0.22 | Wurth Elektronik | 865090468011 | 710-865090468011
LED verde | D3 | LED | Diode_SMD:D_0805_2012Metric | https://ar.mouser.com/ProductDetail/Dialight/598-8C80-102F?qs=hWgE7mdIu5QufY11KQ%2FRug%3D%3D | 39.18 ARS | $0.28 | 1 | $0.28 | Dialight | 598-8C80-102F | 645-598-8C80-102F
LED naranja | D2 | LED | Diode_SMD:D_0805_2012Metric | https://ar.mouser.com/ProductDetail/Dialight/598-8C30-102F?qs=hWgE7mdIu5QsN4%252BAG7KlCg%3D%3D | 34.15 ARS | $0.24 | 1 | $0.24 | Dialight | 598-8C30-102F | 645-598-8C30-102F
Resistencia de 10R | R25, R23 | 110R | Resistor_SMD:R_0805_2012Metric | https://ar.mouser.com/ProductDetail/Vishay-Dale/CRCW0805110RFKEAC?qs=E3Y5ESvWgWMNpf%252BYjZabPQ%3D%3D | 16.07 ARS | $0.11 | 2 | $0.23 | Vishay / Dale | CRCW0805110RFKEAC | 71-CRCW0805110RFKEAC
Fusible rearmable de 500mA | F1 | 500mA | Fuse:Fuse_0603_1608Metric | https://ar.mouser.com/ProductDetail/Littelfuse/1812L050-60MR | 92.41 ARS | $0.66 | 1 | $0.66 | Littelfuse | 1812L050/60MR | 576-1812L050/60MR
Diodo de baja caida | D1 | BAT60A | Diode_SMD:D_SOD-323 | https://ar.mouser.com/ProductDetail/Infineon-Technologies/BAT-60A-E6327?qs=QdTgSBuqQUO0UTmzztPfRw%3D%3D | 45.20 ARS | $0.32 | 1 | $0.32 | Infineon Technologies | BAT 60A E6327 | 726-BAT60AE6327
STM microcontrolador | U4 | STM32F103C8Tx | Package_QFP:LQFP-48_7x7mm_P0.5mm | https://ar.mouser.com/ProductDetail/STMicroelectronics/STM32F103CBT6?qs=WxFF5lh7QM3goh6GV5Ogig%3D%3D | 571.56 ARS | $4.08 | 1 | $4.08 | STMicroelectronics | STM32F103CBT6 | 511-STM32F103CBT6
Conversor DC-DC a 5V | U5 | LM2596S-5 | Package_TO_SOT_SMD:TO-263-5_TabPin3 | https://ar.mouser.com/ProductDetail/Texas-Instruments/LM2596S-50-NOPB?qs=X1J7HmVL2ZHVjCOmW%252BYINA%3D%3D | 609.73 ARS | $4.36 | 1 | $4.36 | Texas Instruments | LM2596S-5.0/NOPB | 926-LM2596S-5.0/NOPB
Capacitor de 220uF | C14, C13 | 220uF | Capacitor_SMD:CP_Elec_8x6.9 | https://ar.mouser.com/ProductDetail/Nichicon/PCH1C221MCL1GS?qs=vmHwEFxEFR%2FMyJp93I%2F7QA%3D%3D | 212.95 ARS | $1.52 | 2 | $3.04 | Nichicon | PCH1C221MCL1GS | 647-PCH1C221MCL1GS
Inductor de 33uH | L1 | 33uH | Inductor_SMD:L_TDK_SLF6045 | https://ar.mouser.com/ProductDetail/Taiyo-Yuden/NS10145T330MNV8?qs=hWgE7mdIu5SA9O15JDEKtw%3D%3D | 177.80 ARS | $1.27 | 1 | $1.27 | Taiyo Yuden | NS10145T330MNV8 | 963-NS10145T330MNV8
Conversor lineal 5V a 3,3V | U6 | AMS1117-3.3 | Package_TO_SOT_SMD:SOT-223-3_TabPin2 | https://ar.mouser.com/ProductDetail/Texas-Instruments/LM1117MPX-33-NOPB | 66.00 ARS | $0.47 | 1 | $0.47 | Texas Instruments | LM1117MPX-3.3/NOPB | 926-LM1117MPX3.3NOPB
Diodo Schotky | D4 | 1N5822 | Diode_THT:D_DO-201AD_P15.24mm_Horizontal | https://ar.mouser.com/ProductDetail/STMicroelectronics/1N5822?qs=JV7lzlMm3yJ50hlrGV6%252BnQ%3D%3D | 115.52 ARS | $0.83 | 1 | $0.83 | STMicroelectronics | 1N5822 | 511-1N5822
Conector de bateria | J13, J14 | Batería2 | Battery:BatteryHolder_MPD_BH-18650-PC2 | https://ar.mouser.com/ProductDetail/Keystone-Electronics/1043?qs=%2F7TOpeL5Mz6j%2FnxeOA1rsg%3D%3D | 259.16 ARS | $1.85 | 2 | $3.70 | Keystone Electronics | 1043 | 534-1043
Bateria 18650 | BAT1, BAT2 | Batería2 | 18650 | https://articulo.mercadolibre.com.ar/MLA-816550268-pila-bateria-recargable-18650-6800mah-37v-para-linterna-_JM | 427.00 ARS | $3.05 | 2 | $6.10 | 18650 | 18650 | 18650
Motores 6V | MOT1, MOT2 | Motor izquierda | 6V | https://ar.mouser.com/ProductDetail/TinyCircuits/ASR00016?qs=55YtniHzbhCxReJw9pjq7w%3D%3D | 750.36 ARS | $5.36 | 2 | $10.72 | TinyCircuits | ASR00016 | 406-ASR00016
Llantas para motor | YANT1, YANT2 | Llantas | Para motor | https://teslabem.com/tienda/par-de-llantas-negras-pololu-32x7mm-para-micromotor/ | 189.00 ARS | $1.35 | 2 | $2.70 | Impreso | 2343
Rueda loca | RL | Rueda loca | 3/8 inch | https://robots-educativos.ddns.net/es/kits/2389-pololu-ball-caster-with-3-8-inch-metal-ball.html | 172.00 ARS | $1.23 | 1 | $1.23 | POLOLU | P000951
Soporte motor | MT | Soporte | Pololu | https://robots-educativos.ddns.net/es/kits/2395-pololu-micro-metal-gearmotor-bracket-pair-black.html | 427.00 ARS | $3.05 | 2 | $6.10 | POLOLU | P000989
Precio total | $76.65
 | $10731.68
