GabiAndi/UNER_Autito_PCB/Step/TCRT5000.STEP

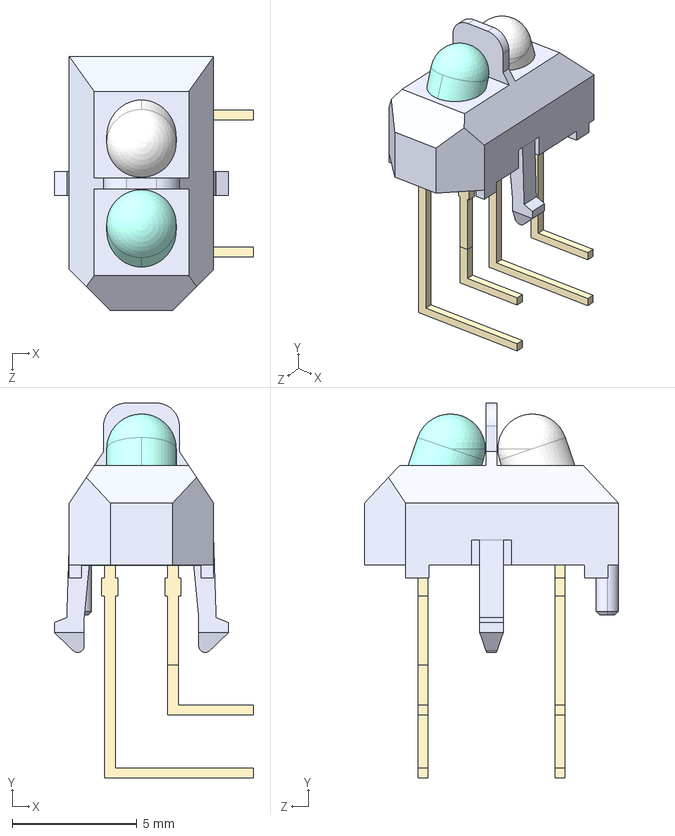
[picture p25: CAD file, 2021-04-09]
Step/TCRT5000.STEP
8.01 x 15.1 x 10.2 mm
TCRT5000 v1
LEDs
Metal Contacts
