GabiAndi/UNER_Autito_PCB/Step/Pololu_Ball_Caster.stp

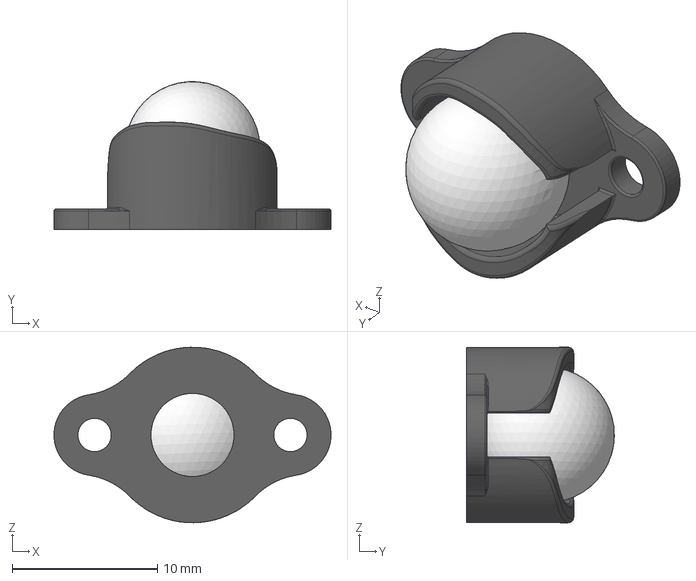
[picture p26: CAD file, 2021-04-09]
Step/Pololu_Ball_Caster.stp
19.0 x 10.2 x 12.1 mm
base
ball
