GabiAndi/UNER_Autito_PCB/Step/Bracket_Pololu.stp

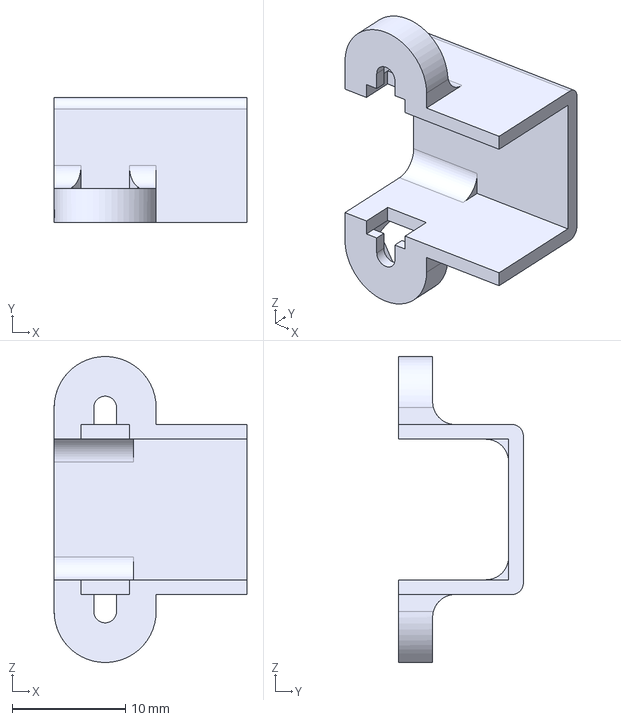
[picture p27: CAD file, 2021-04-09]
Step/Bracket_Pololu.stp
17.0 x 11.0 x 27.0 mm
