GabiAndi/UNER_Autito_PCB/Step/Pololu-Wheel-32x7mm.stp

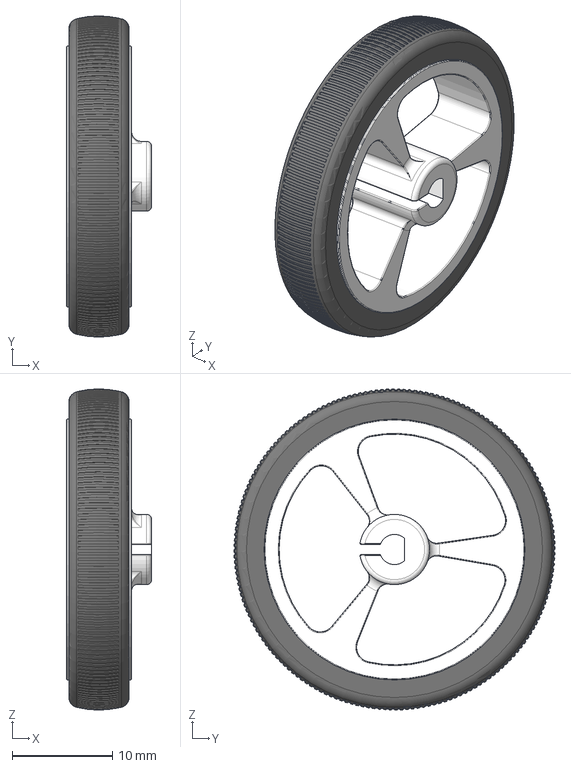
[picture p28: CAD file, 2021-04-09]
Step/Pololu-Wheel-32x7mm.stp
8.50 x 32.0 x 32.0 mm
