GabiAndi/UNER_Autito_PCB/Autito Microcontroladores.kicad_pcb

## KiCad design Autito Microcontroladores.kicad_pcb (2021-04-20)

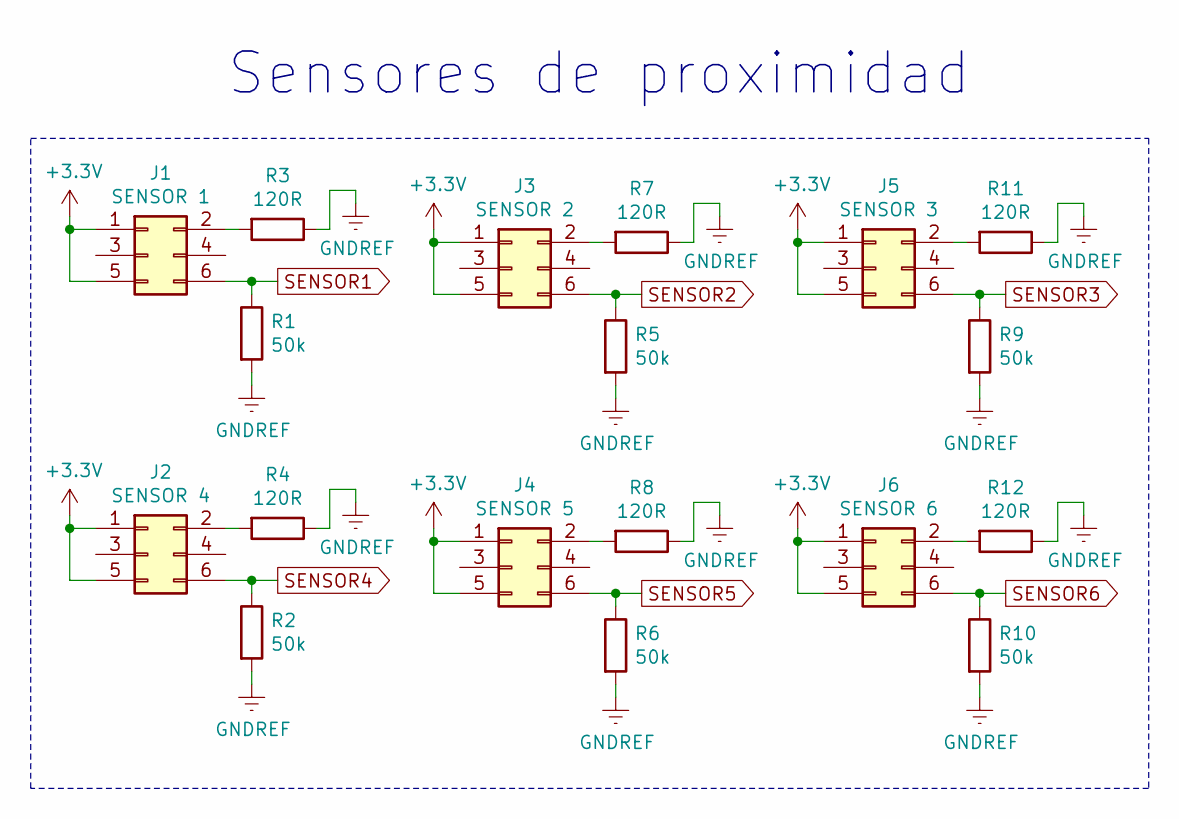
[picture p29: schematic Sensores.sch]

Parts:
J1: SENSOR 1; TCRT5000
J2: SENSOR 4; TCRT5000
J3: SENSOR 2; TCRT5000
J4: SENSOR 5; TCRT5000
J5: SENSOR 3; TCRT5000
J6: SENSOR 6; TCRT5000
R1, R2, R5, R6, R9, R10: 50k; R_0805_2012Metric
R3, R4, R7, R8, R11, R12: 120R; R_0805_2012Metric

Connections:
+3V3: J1.1, J1.5, J2.1, J2.5, J3.1, J3.5, J4.1, J4.5, J5.1, J5.5, J6.1, J6.5; also elsewhere on the board
unnamed: J1.2, R3.2
unnamed: J2.2, R4.2
unnamed: J3.2, R7.2
unnamed: J4.2, R8.2
unnamed: J5.2, R11.2
unnamed: J6.2, R12.2
SENSOR1: J1.6, R1.1; also elsewhere on the board
SENSOR2: J3.6, R5.1; also elsewhere on the board
SENSOR3: J5.6, R9.1; also elsewhere on the board
SENSOR4: J2.6, R2.1; also elsewhere on the board
SENSOR5: J4.6, R6.1; also elsewhere on the board
SENSOR6: J6.6, R10.1; also elsewhere on the board

Notes on the sheet:
Sensores de proximidad

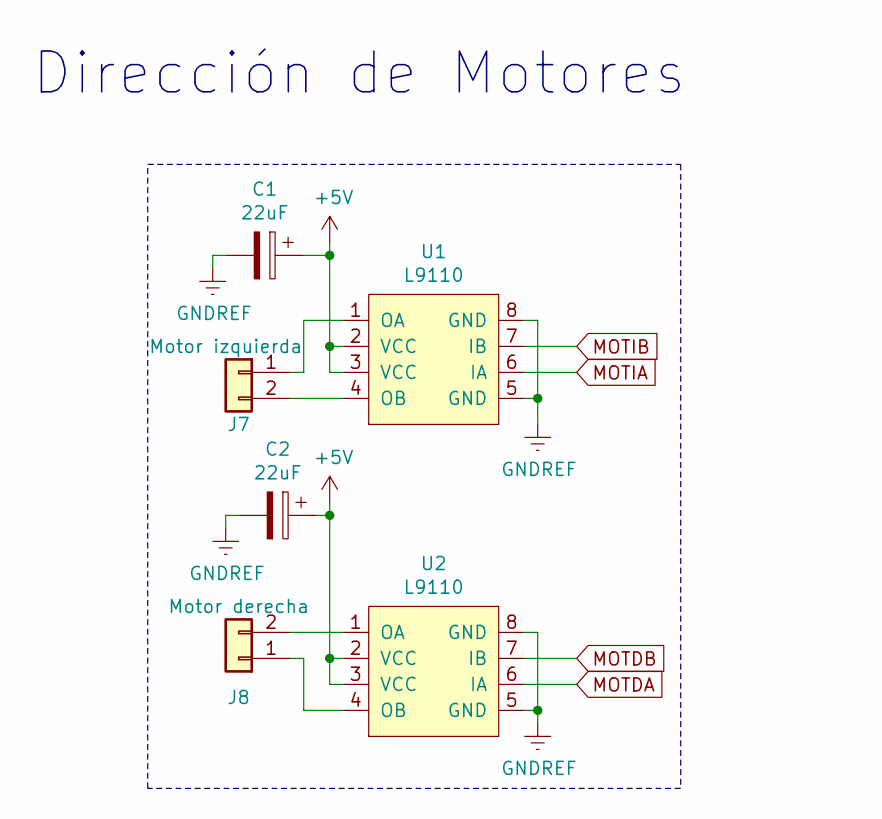
[picture p30: schematic Puente H.sch]

Parts:
C1, C2: 22uF; CP_Elec_6.3x9.9
J7: Motor izquierda; JST_EH_B2B-EH-A_1x02_P2.50mm_Vertical
J8: Motor derecha; JST_EH_B2B-EH-A_1x02_P2.50mm_Vertical
U1, U2: L9110; DIP-8_W7.62mm

Connections:
+5V: C1.1, C2.1, U1.2 (VCC), U1.3 (VCC), U2.2 (VCC), U2.3 (VCC); also elsewhere on the board
MOTDA: U2.6 (IA); also elsewhere on the board
MOTDB: U2.7 (IB); also elsewhere on the board
MOTIA: U1.6 (IA); also elsewhere on the board
MOTIB: U1.7 (IB); also elsewhere on the board
unnamed: J7.1, U1.1 (OA)
unnamed: J7.2, U1.4 (OB)
unnamed: J8.1, U2.4 (OB)
unnamed: J8.2, U2.1 (OA)

Notes on the sheet:
Dirección de Motores

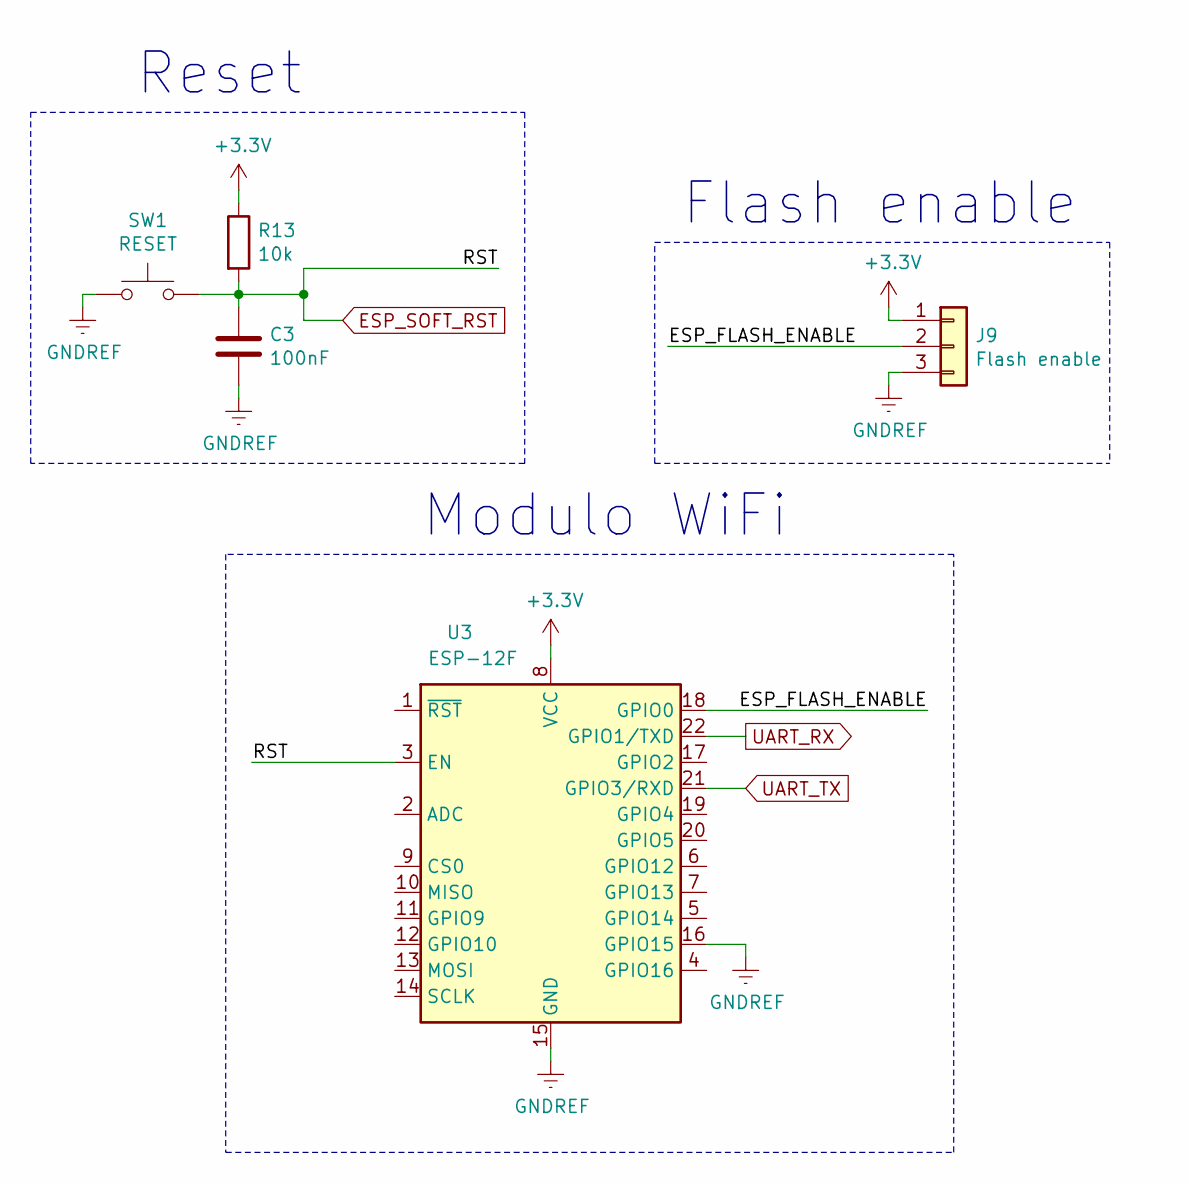
[picture p31: schematic WiFi.sch]

Parts:
C3: 100nF; C_0805_2012Metric
J9: Flash enable; PinHeader_1x03_P2.54mm_Vertical
R13: 10k; R_0805_2012Metric
SW1: RESET; SW_SPST_CK_RS282G05A3
U3: ESP-12F; ESP-12E

Connections:
+3V3: J9.1, R13.1, U3.8 (VCC); also elsewhere on the board
/WiFi/ESP_FLASH_ENABLE: J9.2, U3.18 (GPIO0)
ESP_SOFT_RST: C3.1, R13.2, SW1.2, U3.3 (EN); also elsewhere on the board
UART_RX: U3.22 (GPIO1/TXD); also elsewhere on the board
UART_TX: U3.21 (GPIO3/RXD); also elsewhere on the board

Notes on the sheet:
Reset
Modulo WiFi
Flash enable

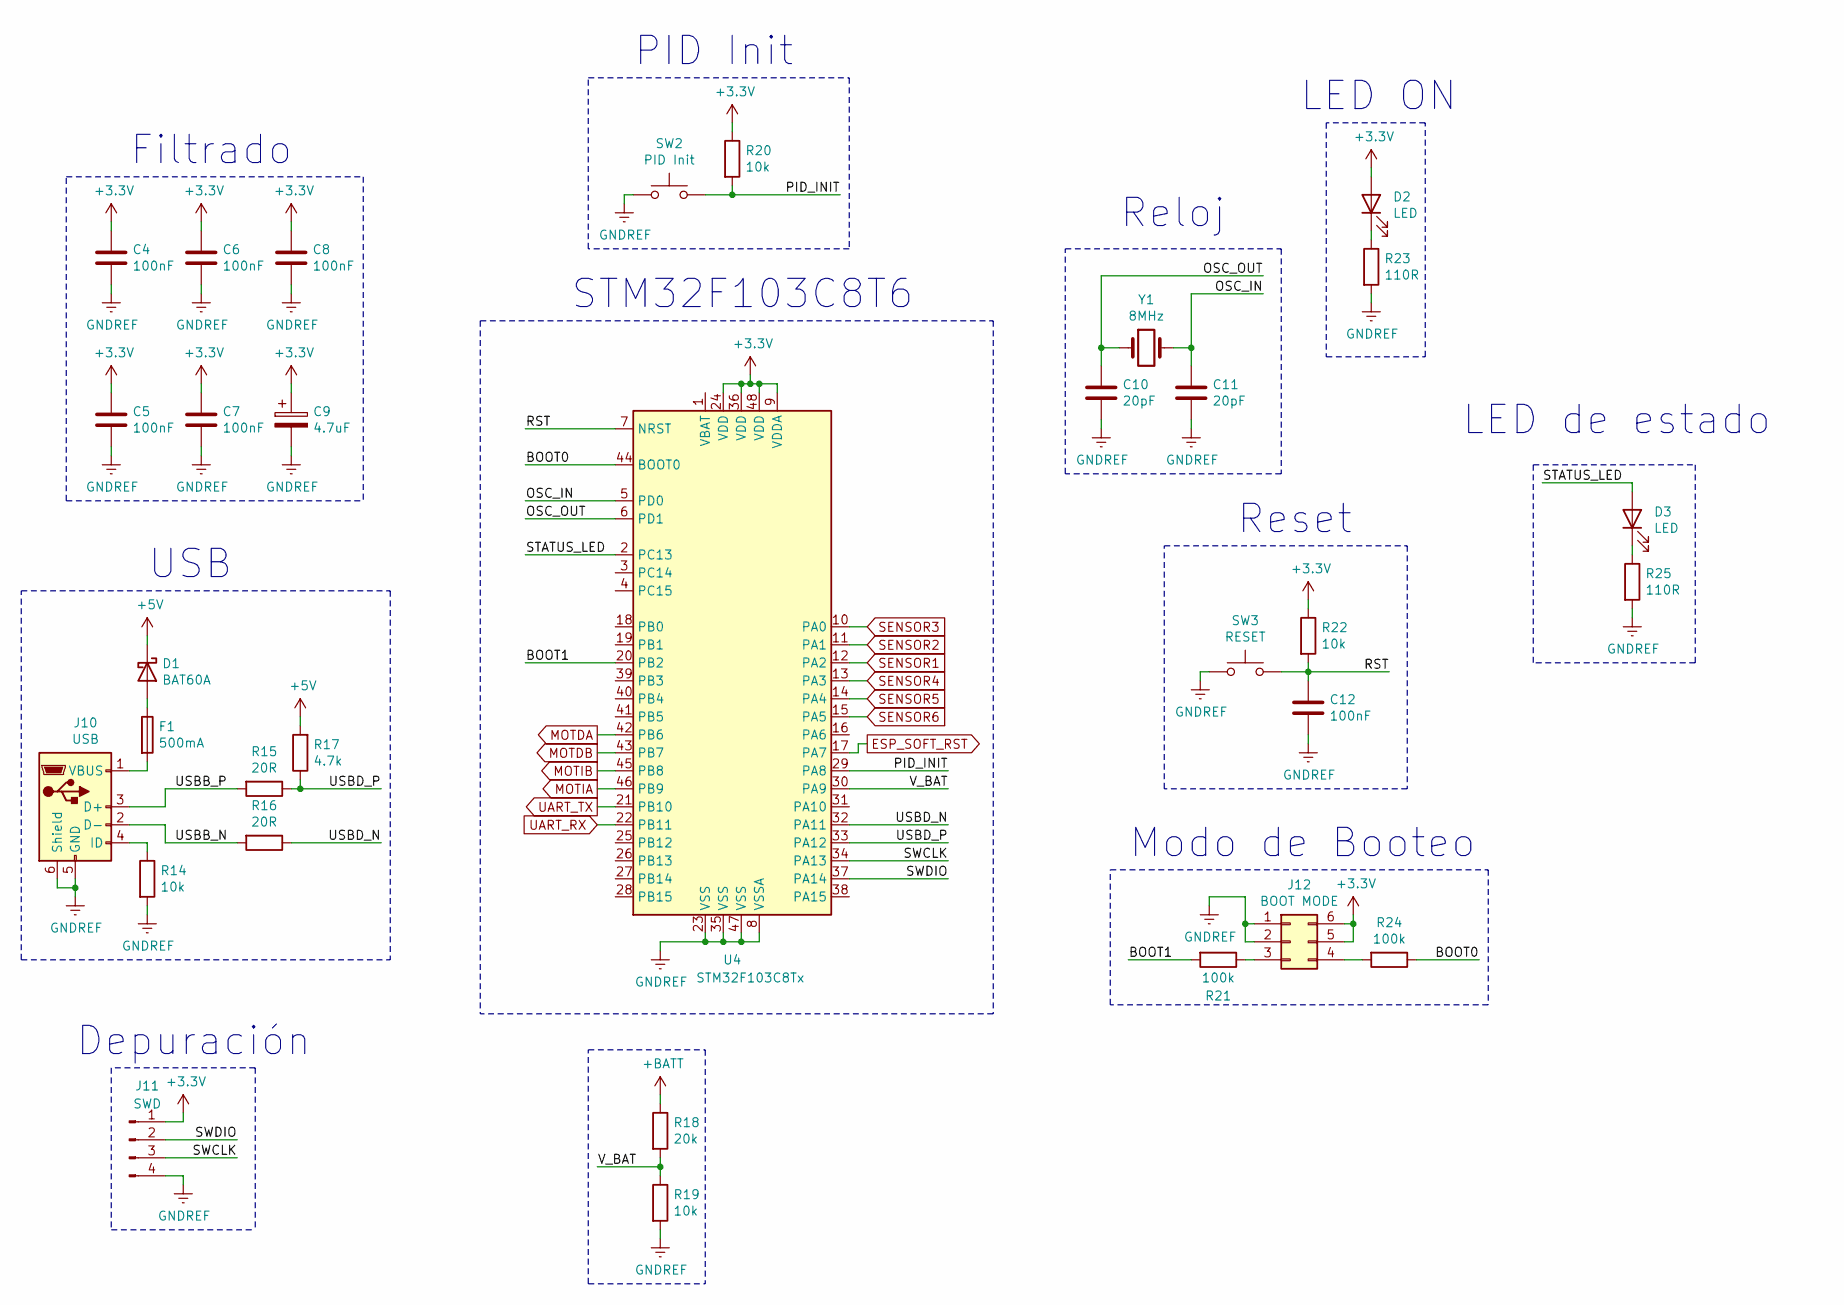
[picture p32: schematic Microcontrolador.sch]

Parts:
C4, C5, C6, C7, C8, C12: 100nF; C_0805_2012Metric
C9: 4.7uF; CP_Elec_3x5.4
C10, C11: 20pF; C_0805_2012Metric
D1: BAT60A; D_SOD-323
D2, D3: LED; D_0805_2012Metric
F1: 500mA; Fuse_0603_1608Metric
J10: USB; USB_Micro-B_Molex_47346-0001
J11: SWD; PinHeader_1x04_P2.54mm_Vertical
J12: BOOT MODE; PinHeader_2x03_P2.54mm_Vertical
R14, R19, R20, R22: 10k; R_0805_2012Metric
R15, R16: 20R; R_0805_2012Metric
R17: 4.7k; R_0805_2012Metric
R18: 20k; R_0805_2012Metric
R21, R24: 100k; R_0805_2012Metric
R23, R25: 110R; R_0805_2012Metric
SW2: PID Init; SW_SPST_CK_RS282G05A3
SW3: RESET; SW_SPST_CK_RS282G05A3
U4: STM32F103C8Tx; LQFP-48_7x7mm_P0.5mm
Y1: 8MHz; Crystal_SMD_HC49-SD

Connections:
+3V3: C4.1, C5.1, C6.1, C7.1, C8.1, C9.1, D2.2 (A), J11.1, J12.5, J12.6, R20.1, R22.1, U4.9 (VDDA), U4.24 (VDD), U4.36 (VDD), U4.48 (VDD); also elsewhere on the board
+5V: D1.1 (K), R17.2; also elsewhere on the board
+BATT: R18.1; also elsewhere on the board
/Microcontrolador/BOOT0: R24.1, U4.44 (BOOT0)
/Microcontrolador/BOOT1: R21.2, U4.20 (PB2)
/Microcontrolador/OSC_IN: C11.1, U4.5 (PD0), Y1.2
/Microcontrolador/OSC_OUT: C10.1, U4.6 (PD1), Y1.1
/Microcontrolador/PID_INIT: R20.2, SW2.2, U4.29 (PA8)
/Microcontrolador/RST: C12.1, R22.2, SW3.2, U4.7 (NRST)
/Microcontrolador/STATUS_LED: D3.2 (A), U4.2 (PC13)
/Microcontrolador/SWCLK: J11.3, U4.34 (PA13)
/Microcontrolador/SWDIO: J11.2, U4.37 (PA14)
/Microcontrolador/USBB_N: J10.2 (D-), R16.2
/Microcontrolador/USBB_P: J10.3 (D+), R15.2
/Microcontrolador/USBD_N: R16.1, U4.32 (PA11)
/Microcontrolador/USBD_P: R15.1, R17.1, U4.33 (PA12)
/Microcontrolador/V_BAT: R18.2, R19.1, U4.30 (PA9)
ESP_SOFT_RST: U4.17 (PA7); also elsewhere on the board
MOTDA: U4.42 (PB6); also elsewhere on the board
MOTDB: U4.43 (PB7); also elsewhere on the board
MOTIA: U4.46 (PB9); also elsewhere on the board
MOTIB: U4.45 (PB8); also elsewhere on the board
unnamed: D1.2 (A), F1.1
unnamed: D2.1 (K), R23.1
unnamed: D3.1 (K), R25.1
unnamed: F1.2, J10.1 (VBUS)
unnamed: J10.4 (ID), R14.1
unnamed: J12.3, R21.1
unnamed: J12.4, R24.2
SENSOR1: U4.12 (PA2); also elsewhere on the board
SENSOR2: U4.11 (PA1); also elsewhere on the board
SENSOR3: U4.10 (PA0); also elsewhere on the board
SENSOR4: U4.13 (PA3); also elsewhere on the board
SENSOR5: U4.14 (PA4); also elsewhere on the board
SENSOR6: U4.15 (PA5); also elsewhere on the board
UART_RX: U4.22 (PB11); also elsewhere on the board
UART_TX: U4.21 (PB10); also elsewhere on the board

Notes on the sheet:
LED de estado
Reloj
PID Init
STM32F103C8T6
LED ON
Reset
Modo de Booteo
Filtrado
USB
Depuración

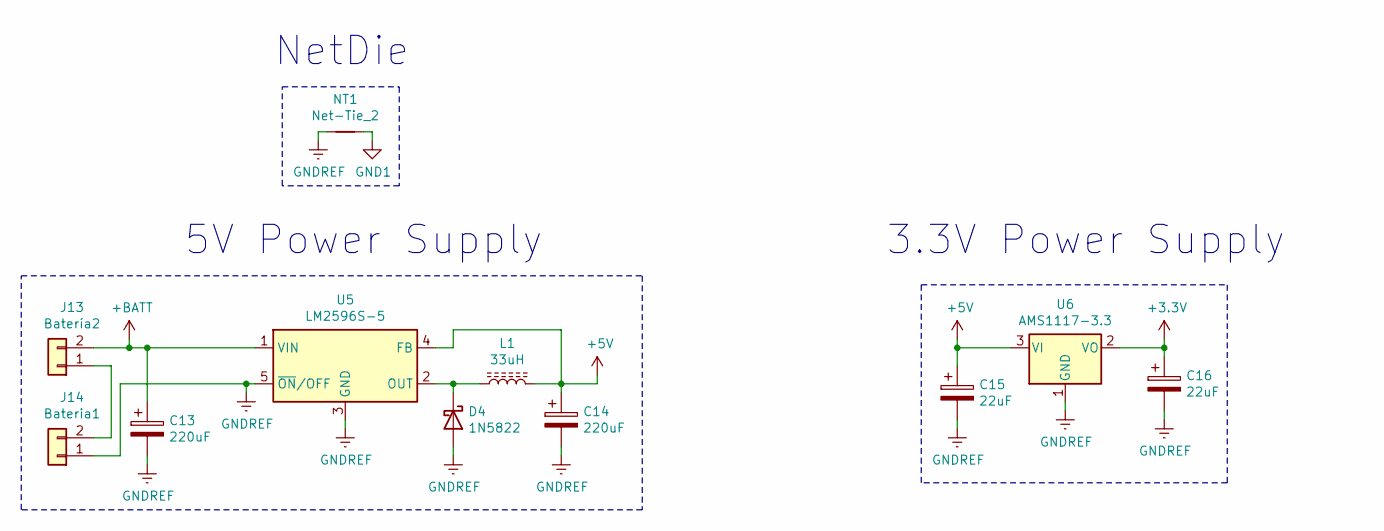
[picture p33: schematic Alimentacion.sch, Alimentación]

Parts:
C13, C14: 220uF; CP_Elec_8x6.9
C15, C16: 22uF; CP_Elec_4x5.8
D4: 1N5822; D_DO-201AD_P15.24mm_Horizontal
J13: Batería2; BatteryHolder_MPD_BH-18650-PC2
J14: Bateria1; BatteryHolder_MPD_BH-18650-PC2
L1: 33uH; L_TDK_SLF6045
NT1: Net-Tie_2; NetTie-2_SMD_Pad2.0mm
U5: LM2596S-5; TO-263-5_TabPin3
U6: AMS1117-3.3; SOT-223-3_TabPin2

Connections:
+3V3: C16.1, U6.2 (VO); also elsewhere on the board
+5V: C14.1, C15.1, L1.2, U5.4 (FB), U6.3 (VI); also elsewhere on the board
+BATT: C13.1, J13.2, U5.1 (VIN); also elsewhere on the board
unnamed: D4.1 (K), L1.1, U5.2 (OUT)
unnamed: J13.1, J14.2

Notes on the sheet:
5V Power Supply
3.3V Power Supply
NetDie

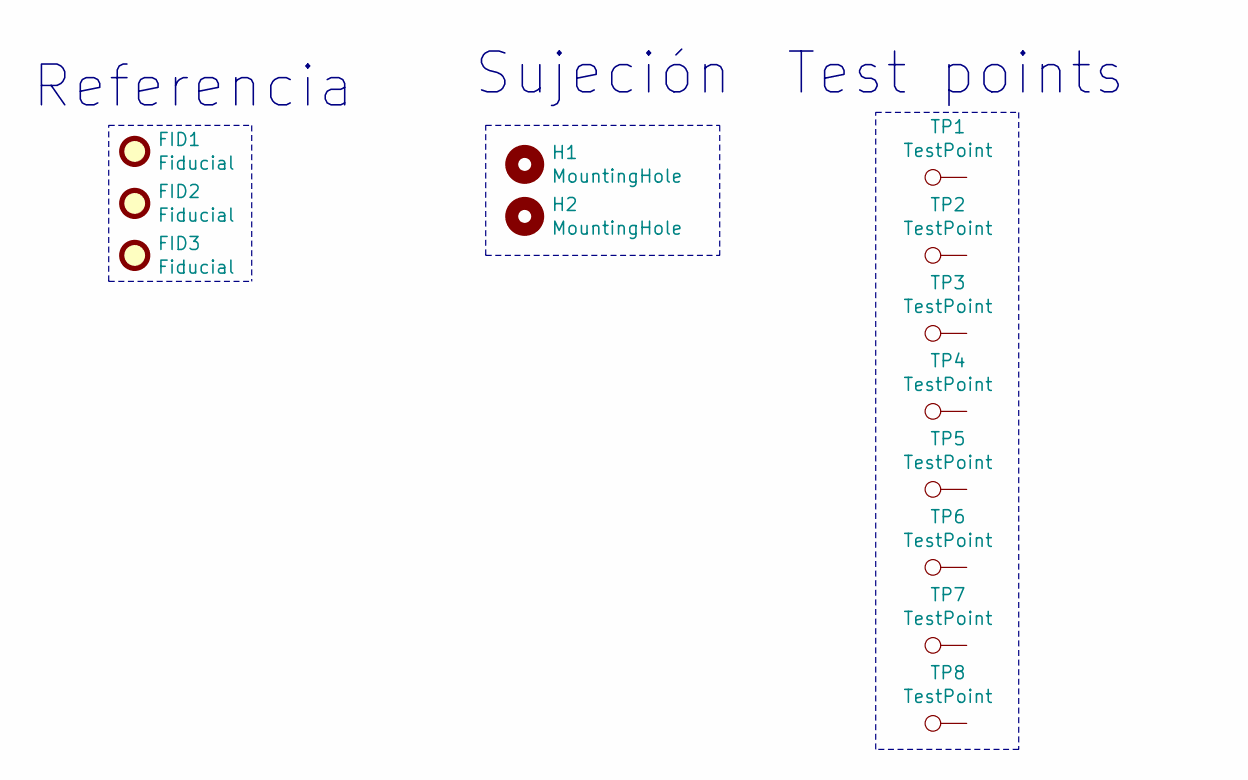
[picture p34: schematic Sujeciones.sch]

Parts:
FID1, FID2, FID3: Fiducial; Fiducial_1mm_Mask2mm
H1, H2: MountingHole; MountingHole_3.2mm_M3_Pad_Via
TP1, TP2, TP3, TP4, TP5, TP6, TP7, TP8: TestPoint; TestPoint_Pad_D3.0mm

Notes on the sheet:
Sujeción
Test points
Referencia

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
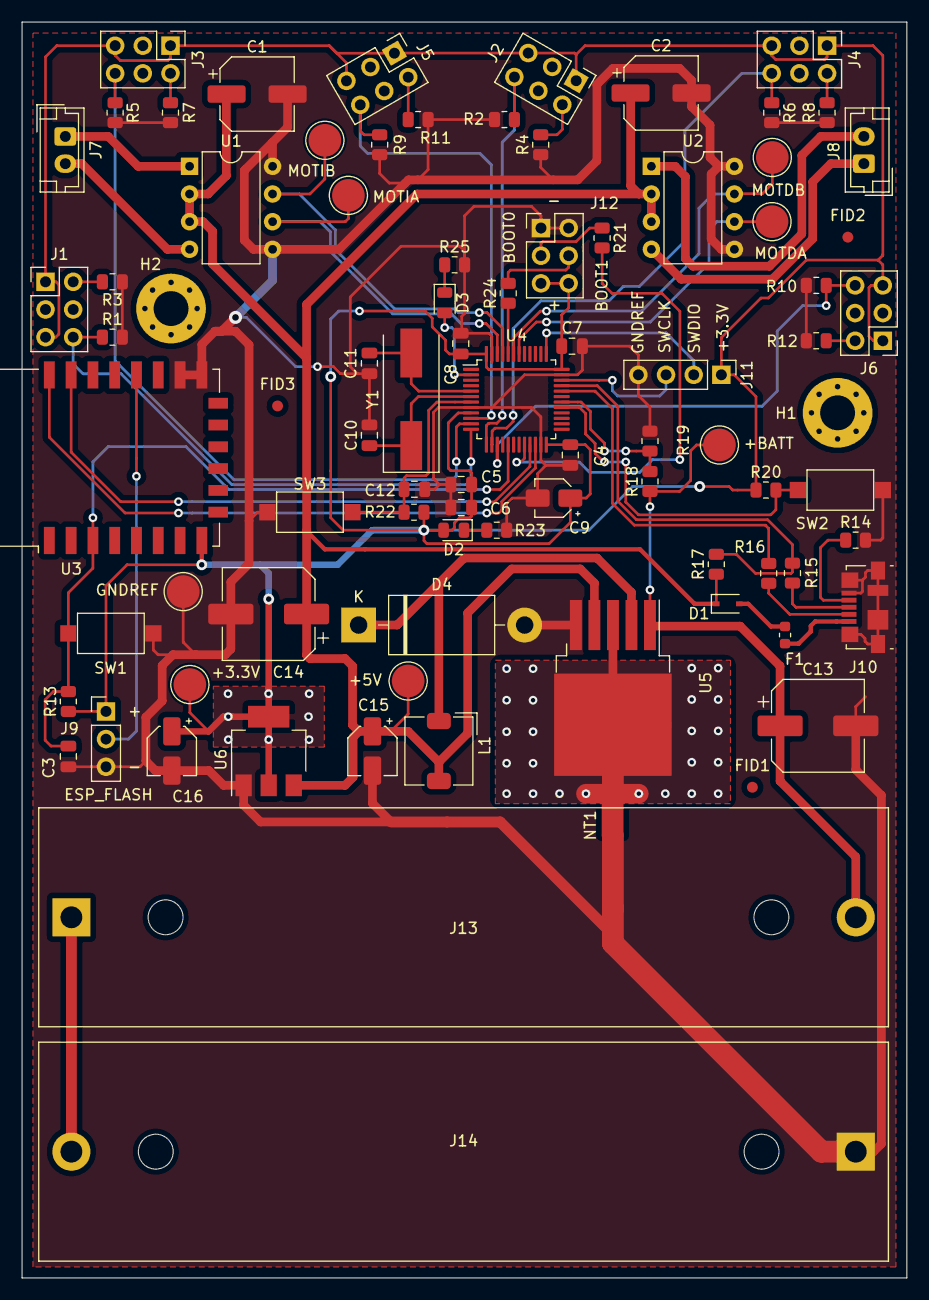
[picture p35: board Autito Microcontroladores.kicad_pcb from above]

Board: 2 copper layers, 81.2 x 115.3 mm, 85 parts (0 on the bottom side), 52 nets.

Other parts of the board:
+3.3V, +5V: TestPoint; TestPoint_Pad_D3.0mm
+BATT: TestPoint; TestPoint_Pad_D3.0mm
GNDREF: TestPoint; TestPoint_Pad_D3.0mm
MOTDA: TestPoint; TestPoint_Pad_D3.0mm
MOTDB: TestPoint; TestPoint_Pad_D3.0mm
MOTIA: TestPoint; TestPoint_Pad_D3.0mm
MOTIB: TestPoint; TestPoint_Pad_D3.0mm

Their connections:
+3V3: +3.3V.1; also elsewhere on the board
+5V: +5V.1; also elsewhere on the board
+BATT: +BATT.1; also elsewhere on the board
MOTDA: MOTDA.1; also elsewhere on the board
MOTDB: MOTDB.1; also elsewhere on the board
MOTIA: MOTIA.1; also elsewhere on the board
MOTIB: MOTIB.1; also elsewhere on the board
