GabiAndi/UNER_Autito_PCB/(commit log)

2021-03-20 Diseño completo
    Esquemático y PCB completo
    [Alimentacion.sch, Autito Microcontroladores.kicad_pcb, Autito Microcontroladores.sch, Microcontrolador.sch, Puente H.sch, Sensores.sch, WiFi.sch]
2021-03-22 Planos de tierra
    Terminado el PCB con sujeciones
    [Alimentacion.sch, Autito Microcontroladores.kicad_pcb, Autito Microcontroladores.sch, Microcontrolador.sch, Puente H.sch, Sensores.sch, Sujeciones.sch, WiFi.sch]
2021-04-09 Placa terminada
    [Alimentacion.sch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]
2021-04-12 Entrega de PCB
    [Autito Microcontroladores-B_Cu.gbr, Autito Microcontroladores-B_Mask.gbr, Autito Microcontroladores-B_Paste.gbr, Autito Microcontroladores-B_SilkS.gbr, Autito Microcontroladores-Edge_Cuts.gbr, Autito Microcontroladores-F_Cu.gbr, Autito Microcontroladores-F_Mask.gbr, Autito Microcontroladores-F_Paste.gbr]
